vlad-anisov/misha/README.md

# Регулируемая сварная рама домашнего автосимулятора (ревизия 4)

## С чего начать

| Файл | Для кого |
|---|---|
| **[1_Кратко_о_раме.pdf](1_Кратко_о_раме.pdf)** | для всех: что это, как выглядит и регулируется, какие материалы и сколько, какие работы, что осталось решить (10 стр.) |
| **[2_Документация_для_изготовления.pdf](2_Документация_для_изготовления.pdf)** | для мастера, цеха, конструктора: ведомость документов, инструкция по сборке и сварке, допуски, таблицы, ведомость материалов, расчёт, чертежи S01–S12 |
| [docs/06_questions_for_workshop.md](docs/06_questions_for_workshop.md) | короткие вопросы цеху |
| **[docs/07_status_open_items.md](docs/07_status_open_items.md)** | **что осталось решить до заказа резки** |

> ⚠️ **Проект не закончен.** Конструкция проверена по 3D-модели, но до заказа резки нужно решить 4 вопроса:
> сварная рама или с минимумом сварки, ответы цеха, модель рулевой базы, тип сиденья
> (см. [docs/07_status_open_items.md](docs/07_status_open_items.md)).
>
> Комплект для изготовления **одного экземпляра**. Отверстия под конкретные руль, педали и сиденье не
> проектировались (сверлятся по месту). Размеры в мм. **[П]** — предварительные параметры, **[!]** — требуют
> инженерной проверки или уточнения после выбора оборудования.

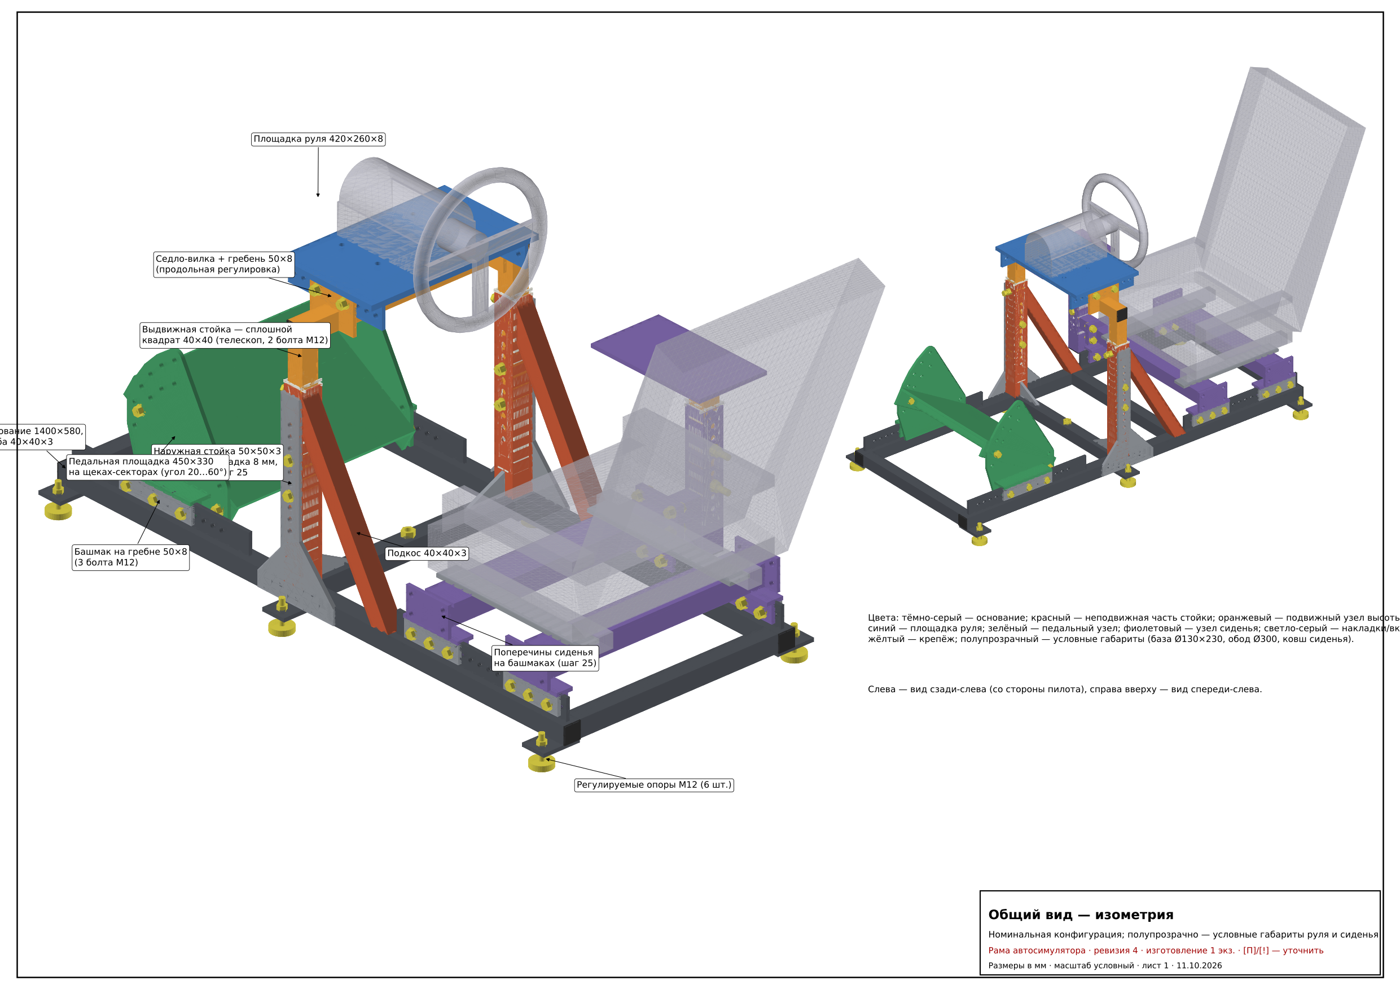
[picture p1: drawings/S01_isometric.png]
Изометрия


## Ключевые параметры [П] (ревизия 4)

| | |
|---|---|
| Основание | **1400 × 580**, труба 40×40×3, 6 регулируемых опор М12 (низ рамы 45 ± 15 от пола; габарит по опорам 686) |
| Металл | Труба 40×40×3, труба 50×50×3, калиброванный квадрат 40×40, лист 8 мм (+ лист 12 мм на площадку руля, 2 мм обычной стали на вкладыши) |
| Рулевые стойки | 50×50×3 на X = 650 (отверстия — труборез), косынки снаружи и изнутри, подкосы 40×40×3 |
| Высота площадки руля | **625…775, шаг 25** (7 положений), номинал 700; телескоп «труба 50×50 + калиброванный квадрат 40×40», 2 болта М12 на стойку, вкладыши по 4 граням + прижим М10; перестановка одним человеком (домкратный винт М16) |
| Руль вперёд-назад | **±75, шаг 25** (7 положений), гребни 50×8 в сёдлах-вилках, 4 болта М12; плавно — салазками сиденья |
| Площадка руля | 420 × 260 × **12**; база снизу или на съёмном фронтальном кронштейне (2 ряда болтов) |
| Педальная площадка | 450 × 330 × 8, угол **20…60°, шаг 10°**; ось X = **260…485, шаг 25**; высота оси **Z 120 / 170** |
| Сиденье | 2 одинаковые поперечины 50×50×3 на X = **1000…1325, шаг 25** (3 болта на конец); адаптеры без отверстий; проставки 8 мм — высота/наклон |
| Шифтер / ручник | Съёмный кронштейн на любой поперечине сиденья, справа или слева, высота **380…480, шаг 25** |
| Масса стали | ≈ 118 кг |
| Крепёж регулировок | М12 8.8 (40 / 45 / 90) в круглых отверстиях, гайки ISO 7042 (замена каждые ~5 перестановок), затяжка 80 Н·м |

## Крайние положения руля (отдельные 3D-изображения)

| Низ + вперёд (H 625, d −75) | Низ + назад (H 625, d +75) |
|---|---|
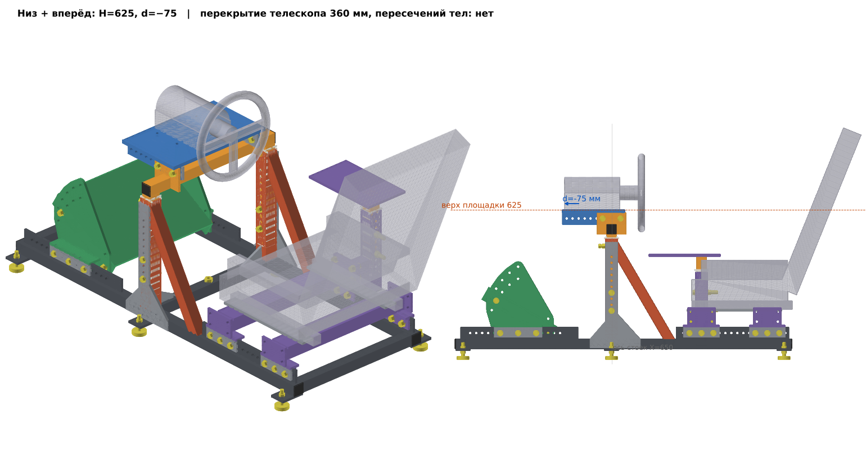
[picture p2: drawings/3d/wheel_low_fwd.png]
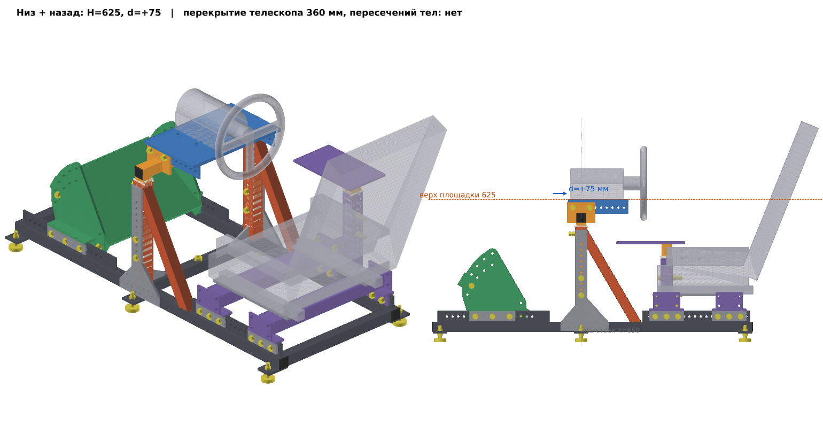
[picture p3: drawings/3d/wheel_low_back.png]
|  |  |
| **Верх + вперёд (H 775, d −75)** | **Верх + назад (H 775, d +75)** |
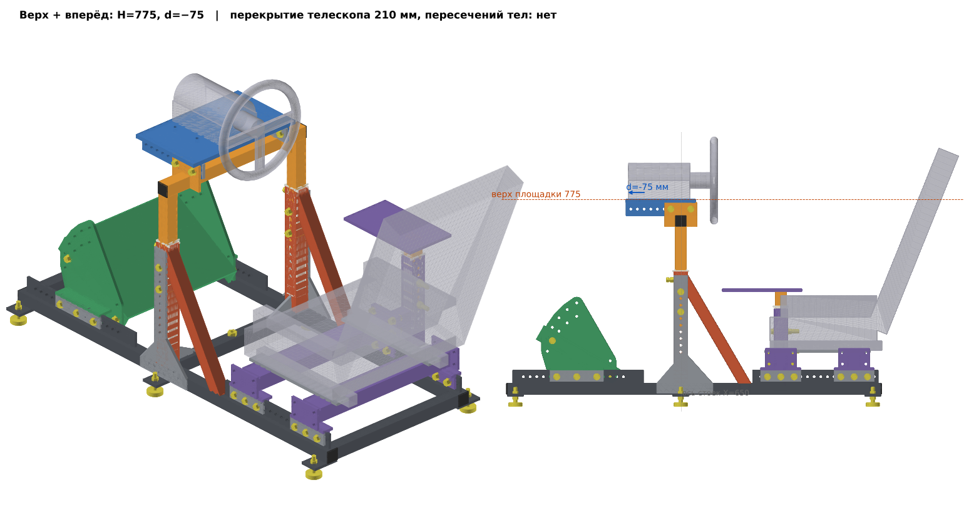
[picture p4: drawings/3d/wheel_high_fwd.png]
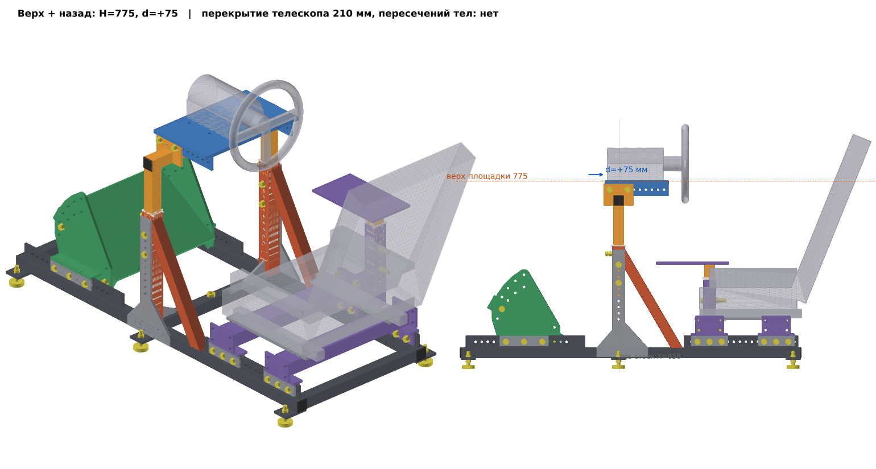
[picture p5: drawings/3d/wheel_high_back.png]
|  |  |

Во всех 16 проверенных конфигурациях (крайние положения руля, педалей, сиденья, кронштейна шифтера, фронтального
крепления) автоматически проверено: пересечений тел нет, каждая гайка сидит на своём болте, **каждый болт можно вынуть
вдоль оси** (`out/interference_report.json`).

## Что где лежит (соответствие пунктам задания)

| № | Требование | Файлы |
|---|---|---|
| 1 | Концепция и обоснование решений | [`docs/01_concept.md`](docs/01_concept.md) |
| 2 | 3D CAD-сборка из отдельных деталей | 188 отдельных тел (200 с фронтальным кронштейном) в группах-подсборках: `out/step/*.step` |
| 3 | STEP AP214 / AP242 + исходник CAD | `out/step/simrig_nominal_AP214.step`, `simrig_nominal_AP242.step`, крайние конфигурации `simrig_<config>_AP214.step`; исходник — параметрическая модель CadQuery `cad/*.py` |
| 4 | STL | `out/stl/simrig_nominal_frame.stl` (каркас), `simrig_nominal_with_refs.stl` (с условными рулём/сиденьем), `simrig_<config>.stl` |
| 5 | Размерные общие виды | `drawings/S01_isometric.png`, `S02_side.png`, `S03_front.png`, `S04_top.png` |
| 6 | Крупные виды механизмов | `drawings/S05_height_mechanism.png`, `S06_foreaft_mechanism.png`; крайние положения — `S07_wheel_extremes.png`, `drawings/3d/` |
| 7 | Схемы регулируемых соединений | `drawings/S09_joint_schemes.png`, `S08_pedal_unit.png`, [`docs/02_adjustable_joints.md`](docs/02_adjustable_joints.md) |
| 8 | Предварительная ведомость материалов и крепежа | [`docs/generated/bom.md`](docs/generated/bom.md) |
| 9 | Параметры к уточнению после выбора оборудования | [`docs/04_open_parameters.md`](docs/04_open_parameters.md) |
| 10 | Почему соединения не смещаются и не расшатываются | [`docs/02_adjustable_joints.md`](docs/02_adjustable_joints.md) §2.1, 2.2, 2.6 |
| — | Нагрузки, допущения, расчёт | [`docs/03_loads_and_checks.md`](docs/03_loads_and_checks.md), [`docs/generated/calc_results.md`](docs/generated/calc_results.md) |
| — | Эргономика P5…P95 | `drawings/S10_ergonomics.png`, `cad/ergonomics.py` |
| — | **Комплект для мастера** | [`docs/05_fabrication_assembly.md`](docs/05_fabrication_assembly.md) (порядок сборки и сварки), `fabrication/dxf/` (лазер, 28 позиций + кондуктор), `fabrication/cut_list.csv` (раскрой и задание на труборез), [`docs/generated/fabrication_tables.md`](docs/generated/fabrication_tables.md), `drawings/S12_laser_parts.png` |
| — | Кронштейн шифтера / ручника | `drawings/S11_shifter_mount.png`, [`docs/02_adjustable_joints.md`](docs/02_adjustable_joints.md) §2.4а |

Все листы одним файлом: `drawings/simrig_concept_drawings.pdf`.

## Как пересобрать

```bash
pip install cadquery matplotlib scipy ezdxf reportlab pypdf
python cad/build.py        # STEP/STL всех конфигураций + проверка столкновений
python calc/frame_fem.py   # стержневая МКЭ-модель, проверки крепежа
python cad/bom.py          # предварительная ведомость
python cad/fabrication.py  # DXF для лазера, раскрой, раскладка деталей
python cad/drawings.py     # листы чертежей и 3D-изображения
python cad/report.py       # 1_Кратко_о_раме.pdf и 2_Документация_для_изготовления.pdf
```

Все размеры — в `cad/params.py`; конфигурации регулировок — `CONFIGS` там же. Система координат:
X от переднего торца к сиденью, Y — поперёк (+ справа от пилота), Z — от пола.

## Ограничения
* Трубы смоделированы без радиусов скругления углов; сварные швы не моделировались.
* Руль, база, сиденье и манекены — условные габариты для проверки компоновки.
* Расчёт — оценочный (идеально жёсткие стыки); реальные перемещения ожидаются в 1.5–3 раза больше.
