vlad-anisov/misha/docs/01_concept.md

# 1. Общая концепция и обоснование решений

> **Статус: комплект для изготовления одного экземпляра (ревизия 4).** Размеры в мм. **[П]** — предварительные
> параметры, **[!]** — требуют инженерной проверки или уточнения после выбора руля, педалей, сиденья.

## 1.1 Состав каркаса

| № | Узел | Решение | Сечения / материал [П] |
|---|---|---|---|
| 1 | Основание | Прямоугольная сварная рама **1400×580**: 2 лонжерона + 4 одинаковые поперечины (X = 20, 650, 890, 1380) | труба 40×40×3 |
| — | «Гребни» | На лонжеронах — гребни 50×8 (лазер, с отверстиями Ø13 шагом 25): педальная зона X 20…510, зона сиденья X 920…1390 | лист 8 мм |
| 2 | Рулевые стойки | Наружные стойки 50×50×3 (отверстия — лазерный труборез) на X = 650, наружная грань заподлицо с лонжероном; косынки снаружи и изнутри | 50×50×3, лист 8 мм |
| 3 | Раскосы | Подкосы назад от стойки (Z≈453) к лонжерону (X=890) + портал «стойки – верхняя поперечина» | 40×40×3 |
| 4 | Высота руля | Телескоп: калиброванный квадрат 40×40 в трубе 50×50×3, вкладыши по 4 граням + прижимной винт М10, 2 болта М12 на стойку; **625…775, шаг 25, номинал 700** | квадрат 40, лист 2 мм нерж. |
| 5 | Руль вперёд-назад | Два гребня 50×8 под площадкой в сёдлах-вилках на верхней поперечине; **±75, шаг 25** | лист 8 мм |
| — | Площадка руля | **420×260×12** (лист 12 — изгиб под базой между гребнями); база снизу или на съёмном **фронтальном кронштейне** (2 ряда болтов) | лист 12 / 8 мм |
| 6 | Педали | Площадка 450×330×8 на оси и одной дуге фиксации; угол **20…60°/10°**, ось **X 260…485/25**, высота оси **Z 120 или 170** | лист 8 мм, рёбра 40×40×3 |
| 7 | Сиденье | 2 **одинаковые** поперечины 50×50×3 на башмаках (3 болта), X **1000…1325/25**; полки 80×8 и адаптерные полосы без отверстий; проставки 8 мм для высоты/наклона | 50×50×3, лист 8 мм |
| 7а | Шифтер / ручник | Съёмный кронштейн на фланце любой поперечины сиденья, справа или слева; телескоп 50/40, высота 380…480/25; платформа 300×170 | 40×40×3, 50×50×3, квадрат 40 |
| 8 | Опоры | 6 точек; пластины выступают наружу (ход шпильки свободен), М12 ×80, ±15 мм; **габарит по опорам 686** | лист 8 мм |
| 9 | Монитор | **Не предусмотрен** (по заданию) | — |

Металл: **труба 40×40×3, труба 50×50×3, калиброванный квадрат 40×40, лист 8 мм** (+ лист 12 мм на площадку руля и
2 мм обычной стали на вкладыши). Масса стали по модели ≈ **118 кг** — рама не ёрзает по полу при торможении с тензодатчиком.

## 1.2 Сквозная идея: одна механика регулировок

Все регулировки — **болты М12 в круглых отверстиях** (положительная фиксация на срез); трение затянутого пакета —
второй уровень. Пазов нет. Для перестановки вдоль рамы везде один узел — **гребень + вилка с прижимной пластиной**:
сплошной гребень 50×8 (нечему сминаться), приварная щека + съёмная прижимная пластина (это одна и та же деталь),
сквозные болты с гайками ISO 7042. Щека стоит с зазором **1 мм** к гребню — допуск на ширину сварной рамы;
зазор выбирает прижимная пластина, поперечины не заклинивает.

## 1.3 Изменения относительно исходных габаритов (с обоснованием)

| Параметр | Исходно | Принято | Почему |
|---|---|---|---|
| Длина основания | ≈1300 | **1400** (+100 спереди) | Проверка P95 (`cad/ergonomics.py`): при 1300 педали упирались в крайнее переднее положение, запаса для высоких не было. +100 спереди дают ход педалей 225 мм |
| Ширина | ≈580 | **580** по лонжеронам; 686 по опорам | Опоры вынесены наружу, чтобы шпилька имела свободный ход вверх |
| Положение стоек | — | X = 650 | Обод на ≈850 — длины рук P5…P95 в норме |
| Высота площадки | ≈625 | **625…775**, шаг 25, номинал 700 | При ободе Ø300 ниже 625 колени P50/P95 касаются обода; 625 — нижнее положение |
| Площадка руля | 420×260 | **420×260×12** | Размер исходный; толщина 12 — база крепится к листу между гребнями (пролёт 360) |
| Педальная площадка | 460×330 | **450×330×8** + рёбра 40×40×3 | −10 мм по ширине — место под гайки оси; прогиб ребра ≈0.09 мм при 1000 Н |
| Стенка труб | 2–3 мм | **3 мм везде** | Одна толщина — мастер не перепутает |
| Наружная стойка | 40×40 | **50×50×3** | Нужна для телескопа с квадратом 40 |

## 1.4 Рулевой узел — как он держит нагрузку

* **Неподвижная часть:** стойки 50×50×3 приварены к лонжеронам и поперечине 40×40×3 под ними, наружная косынка-накладка
  8 мм, внутренняя косынка, подкосы назад — треугольник с каждой стороны. Передний подкос не ставится — он перекрыл бы
  ход педалей.
* **Подвижная часть (П-узел):** два калиброванных квадрата + верхняя поперечина — портал; вкладыши по 4 граням,
  перекрытие в телескопе ≥210 мм.
* **Площадка:** лист 12 мм на двух гребнях (оси через 360 мм) в сёдлах — 2+2 болта.
* Оценка (`calc/frame_fem.py`, база закреплена на листе, стыки идеально жёсткие): центр обода смещается **≈0.9 мм**
  при 1000 Н вниз в худшем положении (H=775, d=+75) и ≈0.55 мм в номинале. **[!]** Реальные значения ожидаются в
  1.5–3 раза больше; подтвердить замером после сборки.

## 1.5 Совместимость с сиденьями

* Поперечины переставляются по гребню (1000…1325, шаг 25), разнос 150…325 мм — под разные салазки и кронштейны.
* Полки 80×8 и адаптерные полосы — **без отверстий**: сверлятся по салазкам/кронштейнам конкретного сиденья.
  Опорная плоскость адаптеров — Z = 211 мм.
* Высота и наклон сиденья: проставки 8 мм (те же полосы, что адаптеры) под обе поперечины (высота) или только
  под заднюю/переднюю (наклон ≈1.5° на проставку).
* Ковш с боковыми кронштейнами: покупные универсальные кронштейны или лазерные Г-образные — после выбора ковша.

## 1.6 История упрощений (ревизии 2–4)

| Было | Стало | Зачем |
|---|---|---|
| Нониус 12.5 мм (4 отв. в седле) | 1 пара отверстий, шаг 25 | Тонкая доводка — салазками сиденья |
| Педали: ось + 2 дуги | Ось + 1 дуга R250 (2 болта на щеку) | Меньше отверстий, нагрузка ≈0.8 кН на болт |
| Трубчатая внутренняя стойка + вварные втулки | **Калиброванный сплошной квадрат 40×40** | Нет втулок, нечему сминаться, жёстче |
| Приварные гайки (48 шт.) | Сквозные болты + ISO 7042 | Нет брызг в резьбе и перекосов гаек |
| Полоса 50×8 / 80×6, лист 6/8, труба 2/3 мм вперемешку | Лазер из листа 8 мм, вся труба 3 мм | Мастер не перепутает |
| Мастер сверлит гребни и стойки | Лазер и труборез, кондуктор Л29 для квадратов | Главный источник брака исключён |
| Щека с зазором 0.2 мм | Зазор 1 мм + прижимная пластина | Сварная рама с обычным допуском не заклинивает поперечины |
| Вкладыши по 2 граням | По 4 граням, комплект 1.5/2.0/2.5 мм, прижимной винт М10 | Нет качки в телескопе |
| Педали с застрявшими болтами (обнаружено проверкой) | Болты вставляются со свободной стороны | Каждый болт вынимается — проверяется автоматически |
| Без шифтера, только нижнее крепление базы | Кронштейн шифтера/ручника; фронтальный кронштейн базы | Функции готовых рам |
| Высота руля 575…725, основание 1300 | 625…775, основание 1400, высота педалей 2 ряда | Эргономика P5…P95 (повторная проверка) |
| Перестановка высоты — вдвоём | Гайка М16 под съёмный домкратный винт | Регулировка одним человеком |

## 1.7 Сравнение с готовыми рамами (~$1000)

| | Наша рама (рев. 4) | Профильные 80×40…160×40 (Sim-Lab GT1 Evo / P1X, Trak Racer TR160) | Playseat Sensation Pro |
|---|---|---|---|
| Жёсткость руля | сварной портал, ≈0.9 мм идеализ. в худшем положении [!] | высокая (профиль, Т-гайки) | ниже, для DD нужен адаптер |
| Фиксация регулировок | болт в круглом отверстии — не проскальзывает | Т-гайки на трении — плавно, но может сползти | фирменные фиксаторы |
| Высота / вылет руля | 625…775 / ±75, шаг 25 | плавно | да |
| Наклон площадки руля | **нет** (вариант — клин/кронштейн после выбора базы) | есть у ряда моделей | да |
| Крепление базы | снизу + фронтальный кронштейн | снизу / спереди / сбоку (опции) | адаптер |
| Педали | угол 20…60°, ход 225, высота 2 ряда | угол, высота, плавно | глубина, высота |
| Сиденье | салазки, проставки (высота/наклон) | слайдер, кронштейны | своё |
| Шифтер / ручник | да, справа/слева | опция | опция |
| Масса | ≈118 кг | 55–65 кг | ≈38 кг |

Вывод: по прочности и надёжности фиксации — не хуже профильных рам; по удобству регулировок — ступенчато и ключом
(против плавных Т-гаек); функционально не хватает только наклона площадки руля (решается после выбора базы).

## 1.8 Что сознательно НЕ спроектировано на этом этапе

* Отверстия под рулевую базу, педали, сиденье, шифтер (оборудование не выбрано).
* Наклон площадки руля — зависит от базы (клин-адаптер или наклонный фронтальный кронштейн).
* Крепление монитора — не предусмотрено по заданию.
* Окончательные моменты затяжки, марки стали, катеты — предварительные (`03_loads_and_checks.md`).
