vlad-anisov/misha/docs/02_adjustable_joints.md

# 2. Регулируемые соединения: схема, принцип фиксации, долговечность

Чертежи: `drawings/S05_height_mechanism.png`, `S06_foreaft_mechanism.png`, `S08_pedal_unit.png`,
`S09_joint_schemes.png`. Крайние положения в 3D: `drawings/3d/*.png`, лист `S07_wheel_extremes.png`.

## 2.1 Высота площадки руля — телескоп с двумя болтами

| | |
|---|---|
| Диапазон / шаг | **625…775 мм** (верх площадки от пола), **шаг 25**, 7 положений, номинал 700 [П] |
| Направляющая | Наружная труба 50×50×3 (неподвижная, шов — на грань X) / **калиброванный сплошной квадрат 40×40** (ГОСТ 8559, h11; оба квадрата связаны верхней поперечиной) |
| Фиксация | **2 болта М12 на стойку**, разнос 75 мм, всего 4; круглые отверстия Ø13 |
| Отверстия | Наружная стойка: ряд 10 отв. шагом 25 (Z = 203…428), режет труборез; в косынке 8 мм — лазер. Квадрат 40×40: 2 отв. на расстоянии 75 — сверлильный станок по лазерному кондуктору Л29 |
| Люфт | **Вкладыши (обычная сталь 2 мм, лазер) по всем 4 граням** — с отверстиями по граням болтов, без отверстий по двум другим; толщина из комплекта 1.5/2.0/2.5 мм (стандартный холоднокатаный лист; остаток зазора ≤0.25 выбирает прижимной винт М10); после подбора приклеиваются к стенке. **Прижимной винт М10** (передняя грань) поджимает вкладыш — выбирает остаточную качку без перетяжки болтов |
| Минимальное перекрытие | 210 мм при H = 775 (≈5 ширин) |
| Доступ | Головки болтов — снаружи каркаса, гайки ISO 7042 — внутри, между стойками (открытый доступ), два ключа 18 мм |

**Почему не смещается и не расшатывается**
1. Вертикальную силу и момент воспринимают два болта в круглых отверстиях на каждой стойке → ни один
   болт не является единственной защитой от поворота; поворот в плане исключён квадратным сечением и
   связью двух стоек поперечиной.
2. Момент от усилия на руле воспринимает телескоп с перекрытием ≥210 мм, а не болты.
3. Пакет под болтом сплошной: косынка 8 + стенка 3 + стальной вкладыш 2 + **сплошной квадрат 40** + вкладыш 2 + стенка 3 →
   ничего не сминается, усилие затяжки не теряется со временем (нет пустот, пластика и краски в пакете).
4. При затяжке 80 Н·м пакет даёт ещё ≈13 кН трения на болт — с большим запасом к рабочим нагрузкам.
5. Люфт убирается подбором вкладыша (один раз при сборке), а не перетяжкой болтов.

**Почему шаг 25 и диапазон 150:** 25 мм — заметно меньше разброса удобной высоты у одного пилота;
тоньше — проставками 5/10 мм под базой. 150 мм перекрывают P5…P95 (лист S10). Верх ограничен
перекрытием телескопа, низ — зазором между верхней поперечиной и головками вкладышей (≈10 мм).

**Перестановка (одним человеком):** вкрутить съёмный домкратный винт М16 в гайку на поперечине основания до упора
в верхнюю поперечину → отпустить прижимы М10 → вынуть 4 болта → винтом поднять/опустить П-узел на нужный шаг →
вставить болты → затянуть крест-накрест → поджать М10 → выкрутить винт. Подвижная масса с базой ≈35–40 кг.

## 2.2 Площадка руля вперёд-назад — гребни в сёдлах-вилках

| | |
|---|---|
| Ход / шаг | **±75 мм**, **шаг 25**, 7 положений [П]; плавная доводка — салазками сиденья |
| Элементы | Под листом 420×260×12 — 2 гребня 50×8 (лазер, 10 отв. Ø13 шагом 25). На верхней поперечине — 2 седла: приварная щека 8 мм + **съёмная прижимная пластина 8 мм**; гребень опирается прямо на поперечину |
| Фиксация | В седле 2 отверстия на расстоянии 75 мм (±37.5 от оси стоек): **2 болта на седло, 4 на площадку**, симметрично слева и справа. Таблица положений — лист S06 |
| Доступ | Головки — изнутри (снизу, между коленями), гайки ISO 7042 — снаружи щёк (зазор до стойки ≈40 мм) |
| Крепление базы | Нижнее — по шаблону базы в листе площадки 12 мм (после выбора базы); **фронтальное** — съёмный кронштейн (плита 300×222×8, основание 170×330, 2 косынки), 4 болта М12 в **2 ряда с разносом 100 мм**; оба варианта проверены в крайних положениях |

**Почему не смещается**
1. Продольная сила передаётся болтами в **совмещённых круглых отверстиях** (срез), а не трением в пазу.
2. Каждый болт стянут в пакет «приварная щека – гребень – прижимная пластина»: две плоскости трения; на срез
   работает плоскость гребень/щека, прижимная пластина поддерживает болт от изгиба.
3. Опрокидывающий момент (до ≈275 Н·м при 1000 Н на ободе в крайнем заднем положении) воспринимается
   парой болтов на плече 75 мм на каждом из двух сёдел: ≈1.8 кН на болт при несущей способности ≈32 кН.
4. Вертикаль вниз передаётся кромкой гребня прямо на верхнюю поперечину — болты не несут вес.
5. Прижимная пластина съёмная, поэтому затяжка не изгибает щёки и не требует «выбирать зазор».

## 2.3 Педальный узел — угол и положение

| | |
|---|---|
| Угол | **20…60° к горизонту, шаг 10°**, 5 положений [П] |
| Положение | ось качания X = **260…485, шаг 25**, 10 положений [П] |
| Высота | ось качания на Z = **120 или 170** (два ряда отверстий в секторе) |
| Фиксация угла | Ось (болт М12) + 1 болт на дуге R250 **на каждой щеке** = 4 болта |
| Фиксация положения | Каретка = башмак на гребне 50×8: 3 сквозных болта М12 на сторону, гайки ISO 7042 |
| Направление наклона | Сиденье справа, педали слева: **верхний край — влево (к переду), нижний край с осью качания — вправо (к сиденью)**; линия площадки идёт сверху-слева вниз-вправо (листы S02, S08) |
| Площадка | Лист 8 мм без отверстий + 2 ребра 40×40×3; поле 450×330 под будущий адаптер педалей |

Момент от тормоза (оценочно 400 Н·м при 2000 Н) воспринимается парой «ось + дуга» на двух щеках,
а не трением одного болта. Болт дуги ≈0.8 кН, оси ≈1.8 кН (несущая способность ≈32 кН).

## 2.4 Поперечины сиденья

Башмаки 150 мм (приварная щека + прижимная пластина, **3 сквозных болта** с гайками ISO 7042 на конец поперечины) на гребне
50×8, шаг 25, X = 1000…1325. Поперечины одинаковые (фланцы на обоих торцах обеих). Поверх — адаптерные полосы и салазки
сиденья (бесступенчатая доводка ≈±100 мм). Высота/наклон — проставки 8 мм под адаптерные полосы.

## 2.4а Кронштейн шифтера / ручника

| | |
|---|---|
| Крепление | 4 болта М12×40 через фланец 116×72×8 к фланцу на торце любой поперечины сиденья (фланцы на обоих торцах обеих поперечин → справа/слева, ближе/дальше) |
| По X | Едет вместе с поперечиной сиденья и салазками — положение относительно пилота сохраняется |
| Высота | 380…480, шаг 25, 5 положений: стакан 50×50×3 (труборез) + калиброванный квадрат 40×40, 2 болта М12×90, вкладыши по 4 граням |
| Платформа | Лист 300×170×8 без отверстий — шифтер и ручник сверлятся по месту |
| Нагрузки (допущение [!]) | Ручник 500 Н, шифтер 200 Н; смещение рукояти ≈1 мм (консервативно) |

## 2.5 Опоры

Пластина 8 мм под лонжероном, выступающая наружу на 50 мм; гайка М12 приварена снизу к выступающей части — шпилька
свободно проходит вверх. Опора М12×80 с контргайкой, ход ±15 мм. 6 опор (X = 20, 650, 1380); габарит по опорам 686.

## 2.6 Общие правила долговечности (п. 10 задания)

* **Положительная фиксация везде:** все регулировочные болты — в круглых отверстиях, на срез.
  Самопроизвольное смещение возможно только после срезания болта (запас по срезу > 15).
* **Стопорение от самоотвинчивания** (вибрация от DD-базы): цельнометаллические самоконтрящиеся гайки ISO 7042
  + плоские шайбы ISO 7089 + правильная затяжка; дополнительно (по желанию) — фиксатор резьбы средней прочности.
  Пружинные шайбы Гровера **не применять**.
* **Ни одна резьба не нарезана в тонкой стенке:** везде сквозные болты с гайками ISO 7042 (приварные гайки — только 6 шт. под опорами).
* **Нет смятия:** под болтами — сплошные гребни, сплошные квадраты 40×40 или пакеты с косынкой и вкладышами.
* **Нет потери затяжки:** не красить толстым слоем контактные поверхности пакетов (маскировать при
  порошковой покраске или ограничиться грунтом ≤ 40 мкм); не класть пластик в пакет под болт.
* **Затяжка** [!]: М12 8.8 + ISO 7042 — **80 Н·м** (≈ 70 % пробной нагрузки). Затягивать динамометрическим ключом,
  повторно проверить после первых 2–5 часов езды.
* **Обслуживание:** визуальный контроль меток на головках («метка краской») раз в месяц; проверка момента
  раз в 3 месяца. **Гайки ISO 7042 в регулировочных узлах менять примерно каждые 5 перестановок** (стопорящий
  эффект цельнометаллической гайки нормируется на ~5 циклов); болты — при следах смятия.
* **Заменяемость:** вкладыши, прижимные пластины, болты, опоры — съёмные; сварные узлы не трогаются.
* **Допуски, без которых регулировки не работают:** расстояние между внутренними гранями гребней 532 −0/+3 мм (щёки
  стоят с зазором 1 мм); одноимённые отверстия левого/правого гребня — по X ±0.5 мм (гребни прихватываются с
  прикрученными поперечинами как кондуктором) — см. `05_fabrication_assembly.md`.

## 2.7 Порядок регулировки посадки

1. Сиденье: поставить поперечины под салазки → сиденье в среднее положение салазок.
2. Педали: угол площадки → положение каретки так, чтобы при полностью нажатом тормозе колено ≈ 120–140°.
3. Руль по высоте: верх обода ниже линии глаз, колени не касаются обода при выжатых педалях.
4. Руль вперёд-назад: запястье ложится на верх обода при спине на спинке.
5. Доводка салазками сиденья; затяжка всех болтов моментом; метки краской.
