vlad-anisov/misha/docs/06_questions_for_workshop.md

# Вопросы цеху / мастеру (коротко)

**Нужно сделать одну раму для автосимулятора. Чертежи есть (DXF и PDF).**

**Материал:**
- лист стали 8 мм (основная часть деталей) и 12 мм (одна деталь 420×260);
- лист стали 2 мм (обрезки, на прокладки-вкладыши);
- труба **квадратная** 40×40, стенка 3 мм, ≈7,5 м;
- труба **квадратная** 50×50, стенка 3 мм, ≈2,5 м;
- брусок (сплошной квадрат) 40×40, ≈1 м.

**Работа:**
1. **Лазер:** вырезать плоские детали по DXF (≈28 позиций, отверстия Ø13).
2. **Трубы:** нарезать в размер по таблице; в трёх трубах 50×50 — ряд отверстий Ø13 (лазерный труборез или сверление).
3. **Сверление:** по 2 отверстия Ø13 в трёх кусках бруска 40×40.
4. **Сварка:** сварить раму по чертежам и инструкции.
5. **Покраска:** после сварки зачистить и покрасить (порошок или грунт + эмаль).

Гибки нет. Болты, гайки, опоры покупаем сами.

**Вопросы:**
1. Что из этого можете сделать вы, что нужно заказывать отдельно?
2. Сколько будет стоить и сколько по времени?
