vlad-anisov/misha/docs/07_status_open_items.md

# 7. Статус проекта: что осталось решить

> **Проект не закончен.** Конструкция рамы готова и проверена по 3D-модели: регулировки работают, детали не
> пересекаются, каждый болт можно вынуть ключом. Но **до заказа резки** нужно закрыть пункты из группы А.
> Пункты Б можно решить позже: эти детали дозаказываются отдельно или сверлятся по месту.
> Пункты В — дополнения, которых нет у этой рамы (у части готовых рам они есть). Пункты Г выполняются после
> изготовления.

## А. Решить до заказа резки (блокирует)

| № | Вопрос | Почему важно | Что меняется | Кто решает |
|---|---|---|---|---|
| А1 | **Сварная рама (как сейчас) или вариант с минимумом сварки** | Влияет на все детали | Сейчас — сварная. Гибрид (сварное только основание) — переделка большинства деталей | владелец |
| А2 | **Ответы цеха** (`06_questions_for_workshop.md`): есть ли лазерный труборез, лист 12 мм, брусок 40×40, точность отверстий Ø13 | От этого зависят DXF и технология | Нет трубореза — добавить шаблоны для сверления труб; нет листа 12 — площадка 8 мм + рёбра; отверстия хуже Ø13 +0,2 — резать Ø12 и развёртывать | цех → конструктор |
| А3 | **Рулевая база: модель, момент, способ крепления** | Расчёт сделан для базы **до 25 Н·м**, массой до 15 кг. Отверстия под базу в площадке 12 мм лучше сразу вырезать лазером — сверлить 12 мм вручную тяжело | Отверстия в Л11 (или во фронтальной плите Л13); при моменте > 25 Н·м — пересчёт, возможно второй подкос | владелец (выбор) → конструктор |
| А4 | **Сиденье: тип** (на салазках / ковш с боковыми кронштейнами) и высота посадки | Рама рассчитана на салазки на двух поперечинах. Для ковша с боковым креплением нужны **боковые кронштейны — не спроектированы**. При очень низкой посадке (формульная) поперечины могут оказаться высоко | Добавить лазерные боковые кронштейны или опустить поперечины | владелец → конструктор |

## Б. Можно решить позже (не мешает резке основной рамы)

| № | Вопрос | Что сделать |
|---|---|---|
| Б1 | Педали: модель и шаблон крепления | Отверстия в педальной площадке Л18 (8 мм) — сверлить по месту или дозаказать лазером адаптер. Проверить усилие тормоза: заложено до 2000 Н |
| Б2 | Шифтер и ручник: модели | Отверстия в платформе Л28 — по месту. Ручник с усилием > 500 Н — усилить платформу |
| Б3 | Наклон площадки руля | Сейчас нет. Клин-адаптер или наклонная фронтальная плита — после выбора базы |
| Б4 | Покраска: баллончики или порошок | Порошок — маскировать зажимаемые поверхности; баллон — грунт тонким слоем |
| Б5 | Калиброванный или обычный брусок 40×40 | Калиброванный лучше; обычный годится, люфт выбирается вкладышами 1,5/2,0/2,5 |

## В. Чего у рамы нет (дополнения; есть у части готовых рам)

| № | Что | Комментарий |
|---|---|---|
| В1 | Крепление монитора | Исключено заданием. Если понадобится — отдельная стойка на полу (не нагружает раму) или кронштейн к передней поперечине (проектировать отдельно) |
| В2 | Кронштейн под блок питания базы, укладка кабелей | Хомуты и небольшая пластина — по месту после выбора базы |
| В3 | Полка под клавиатуру и мышь, кнопочный блок, держатель планшета | Не спроектировано. На торцах поперечин сиденья 4 одинаковых фланца, один занят кронштейном шифтера — на свободные можно ставить второй такой же кронштейн с полкой |
| В4 | Упор для пяток | Не спроектирован; при необходимости — пластина на педальной площадке |
| В5 | Вибромоторы / басшейкеры | Точки крепления не выделены; ставятся на поперечины сиденья или педальную площадку по месту |
| В6 | Перемещение рамы | Масса ≈118 кг, колёс и ручек нет. Переносить вдвоём или по частям (П-узел руля, педали, поперечины сиденья снимаются) |
| В7 | Коврик / защита пола | Покупной коврик под раму |

## Г. После изготовления (проверки и инструмент)

| № | Что | Зачем |
|---|---|---|
| Г1 | **Пробный узел до полного заказа:** одна стойка руля с бруском и вкладышами | Проверить, что телескоп ходит без люфта и отверстия совпадают |
| Г2 | Проверка допусков после сварки: 532 −0/+3 между гребнями, параллельность стоек | Иначе поперечины и педали будут заклинивать |
| Г3 | Замер прогиба руля под нагрузкой | Расчёт идеализирован, реальный прогиб может быть в 1,5–3 раза больше |
| Г4 | Подтяжка всех болтов после 2–5 часов езды, затем раз в 3 месяца | Болты садятся |
| Г5 | Инструмент: динамометрический ключ (80 Н·м), головка и рожковый ключ 18 мм, винт-домкрат М16×700 | Затяжка и перестановка высоты руля одним человеком |

## Что не рассчитано (инженерная проверка [!])

* Сварные швы — катеты назначены по опыту (3–4 мм), отдельно не рассчитаны.
* Расчёт рамы — стержневой, стыки идеально жёсткие.
* Момент затяжки 80 Н·м и трение в пакетах — ориентир; зависят от покрытия.
