vlad-anisov/misha/docs/03_loads_and_checks.md

# 3. Допущения по нагрузкам и результаты проверок

> Каркас **не заявляется** как рассчитанный на любую Direct Drive базу. Ниже — предварительные
> допущения; после выбора оборудования расчёт (`calc/frame_fem.py`, `cad/ergonomics.py`) повторить.

## 3.1 Предварительные допущения [!]

| Параметр | Принято | Пересчитать, если |
|---|---|---|
| Пиковый момент рулевой базы | ≤ 25 Н·м | база мощнее 25 Н·м или есть режимы «удара» |
| Масса базы + руля | ≤ 15 кг | тяжелее |
| Длина базы / положение обода | база ≈230 мм, обод Ø300 на 330 мм от переднего края площадки, ось на 70 мм выше площадки | другая геометрия базы / фронтальное крепление |
| Вертикальная сила на ободе | 1000 Н вниз (опора рукой при посадке), 600 Н вверх | — |
| Продольная сила на ободе | ±500 Н | — |
| Поперечная сила на ободе | 300 Н | — |
| Тормоз (тензодатчик) | 2000 Н по нормали к площадке | датчик > 150 кг |
| Пилот | 120 кг × 1.5 (динамика) | — |
| Материал | S235 (Ст3сп), E = 210 ГПа | другая сталь |
| Крепёж | М12, класс 8.8, гайки ISO 7042 (класс 8) | другой класс крепежа |

## 3.2 Результаты (сводно; полностью — `docs/generated/calc_results.md`)

| Проверка | Результат | Статус |
|---|---|---|
| Перемещение обода, 1000 Н вниз, H=775, d=+75 (худшее) | ≈0.89 мм вдоль / 0.90 мм вниз (идеализ.; база закреплена на листе 12 мм) | [!] подтвердить замером, ожидать ×1.5–3 |
| То же в номинале (H=700, d=0) | ≈0.56 мм вдоль / 0.51 мм вниз | [!] |
| Перемещение обода, 500 Н вдоль, H=775 | ≈0.76 мм | [!] |
| Поперечно 300 Н + 25 Н·м | ≈0.3 мм | [!] |
| Макс. номинальное напряжение в раме | ≈28 МПа (S235: 235) | ок для концепции; сварные швы — проверить |
| Болт седла в худшем случае | ≈1.8 кН при Fv,Rd ≈ 32 кН | запас >15 |
| Трение пакета М12 при 80 Н·м | ≈13 кН на болт | [!] μ зависит от покрытия (не красить зажимаемые поверхности) |
| Собираемость / обслуживание | Каждый болт вынимается вдоль оси (проверено по модели во всех 16 конфигурациях); торцевая головка 18 мм проходит везде, кроме гаек педального узла и фланца кронштейна — там рожковый ключ | `out/interference_report.json` |
| Реакция направляющих телескопа | ≈0.65 кН на стойку при перекрытии 210 мм (худший из LC1 и продольной силы) | ок |
| Фронтальный кронштейн: 1000 Н на ободе | 285 Н·м на 2 ряда болтов (разнос 100) → ≈1.4 кН отрыва на болт | [!] прогиб листа у болтов — замер |
| Кронштейн шифтера: ручник 500 Н | смещение рукояти ≈1.1 мм (кручение поперечины 50×50×3, консервативно); болты фланца ≈2.8 кН на растяжение | [!] замер после сборки |
| Педали: болт дуги / оси | 0.8 / 1.8 кН | запас >15 |
| Ребро педальной площадки 40×40×3 | σ ≈ 22 МПа, прогиб ≈ 0.09 мм | ок; лист 8 мм — проверить с адаптером педалей |
| Масса стали | ≈118 кг с кронштейном и фронтальным креплением (см. ведомость) | — |
| Опрокидывание пустой рамы вбок силой на ободе | ≈370 Н; с пилотом 80 кг — ≈620 Н (консервативно, плечо по лонжерону; по опорам больше) | пустую раму не тянуть за руль |
| Столкновения деталей | 16 конфигураций (крайние H, d, педали, сиденье, кронштейн шифтера низ/верх/слева, фронтальный кронштейн в крайних положениях) — пересечений нет | `out/interference_report.json` |
| Собираемость крепежа | В каждой конфигурации проверено: каждая гайка целиком сидит на стержне своего болта (длины М12×40/×45/×90 достаточны) | `out/interference_report.json` |
| Эргономика | Подходящих комбинаций регулировок: P5 — 4682, P50 — 4452, P95 — 3534; номинал (H=700, d=0, педали 385/30°) для P50: зазор ног до обода ≈98 мм | лист S10; [!] повторить с реальным сиденьем и рулём |

## 3.3 Ограничения модели

* Стыки — абсолютно жёсткие; податливость сварных узлов, зазоры в отверстиях (Ø13 под М12) и местные деформации
  стенок не учтены. База руля закреплена на листе площадки в точках Y=±40 (условный шаблон).
* Пол и опоры — жёсткие.
* Динамика (резонанс рамы под вибрацией базы) не считалась. **[!]** После изготовления — простой замер:
  индикатор часового типа на ободе при нагрузке 500 Н; при «гудении» — добавить диагональ в основание
  или увеличить стенку стоек.
* Сварные швы не рассчитывались: принимать катет ≥ 3 мм по всему контуру, стойки и косынки — сплошной шов.
