vlad-anisov/misha/docs/04_open_parameters.md

# 4. Параметры, которые нужно уточнить после выбора оборудования

## 4.1 После выбора рулевой базы и руля
1. Пиковый и длительный момент, масса, тип крепления (снизу / спереди / боковые кронштейны).
2. Шаблон отверстий базы → разметка и сверловка площадки (или промежуточная адаптерная пластина).
3. Длина базы и вылет обода → положение обода; повторить `cad/ergonomics.py` и `calc/frame_fem.py`.
4. Диаметр и форма обода (плоский низ, формульный руль) → зазор до коленей, нужный диапазон высоты.
5. Если момент > 25 Н·м: рассмотреть второй подкос, косынки у верхней поперечины.
6. Кабели и блок питания — места крепления (не силовые, на хомутах).

## 4.2 После выбора педалей
1. Шаблон отверстий и габарит основания педалей → адаптерная пластина/рейки на листе 450×330.
2. Максимальная сила тормоза (тензодатчик) → проверка листа, рёбер и болтов оси.
3. Нужный угол площадки (у некоторых педалей свой регулируемый угол) — возможно, достаточно 3 положений.
4. Высота педалей над листом → положение пятки, повторная проверка эргономики.
5. Нужен ли упор для пятки / подножка.

## 4.3 После выбора сиденья
1. Тип: ковш с боковыми кронштейнами / автомобильное с салазками / ковш на салазках.
2. Шаблон отверстий салазок или кронштейнов → сверловка полок поперечин и адаптерных полос.
3. Ширина сиденья (бокс 510 мм в модели) и наклон спинки → проход у стоек и подкосов.
4. Длина салазок и их ход → выбор шага поперечин.
5. Высота точки H → повторная проверка коленей и обода; при низкой точке H может понадобиться
   опустить поперечины (вариант — поперечины между лонжеронами).
6. Вылет спинки за основание (сейчас ≈150–250 мм) и положение поперечин сиденья (1000…1325).

## 4.3а После выбора шифтера и ручника
1. Шаблон крепления устройств → сверловка платформы 300×170 (или адаптер).
2. Усилие ручника (гидравлический/тензо — до 500–800 Н) → проверка кронштейна; при > 500 Н — косынка под платформой
   или платформа 10 мм.
3. Сторона установки (справа/слева) и нужная высота рукояти → выбор положения 380…480.

## 4.3б Наклон площадки руля
Не спроектирован, т.к. зависит от базы: после выбора базы — клиновой адаптер (лазерные щёки + плита) под нижнее
крепление или фронтальный кронштейн с наклонной плитой (5°/10°).

## 4.4 Требует инженерной проверки независимо от оборудования [!]
* Итоговый момент затяжки М12 8.8 с гайками ISO 7042 (ориентир 80 Н·м) — по паспорту крепежа и покрытию.
* Коэффициент трения в пакетах с выбранным покрытием (порошок/цинк/грунт).
* Сварка: катеты, порядок, деформации гребней (длинные полосы — прихватки с шагом и сварка вразбежку).
* Фактическая жёсткость рулевого узла — замер после изготовления.
* Подбор толщины стальных вкладышей телескопа по фактическим размерам труб (допуски ±0.5 мм по наружному размеру,
  внутренний шов наружной трубы — зачистить или ориентировать на грань X).
