vlad-anisov/misha/drawings/S02_side.png

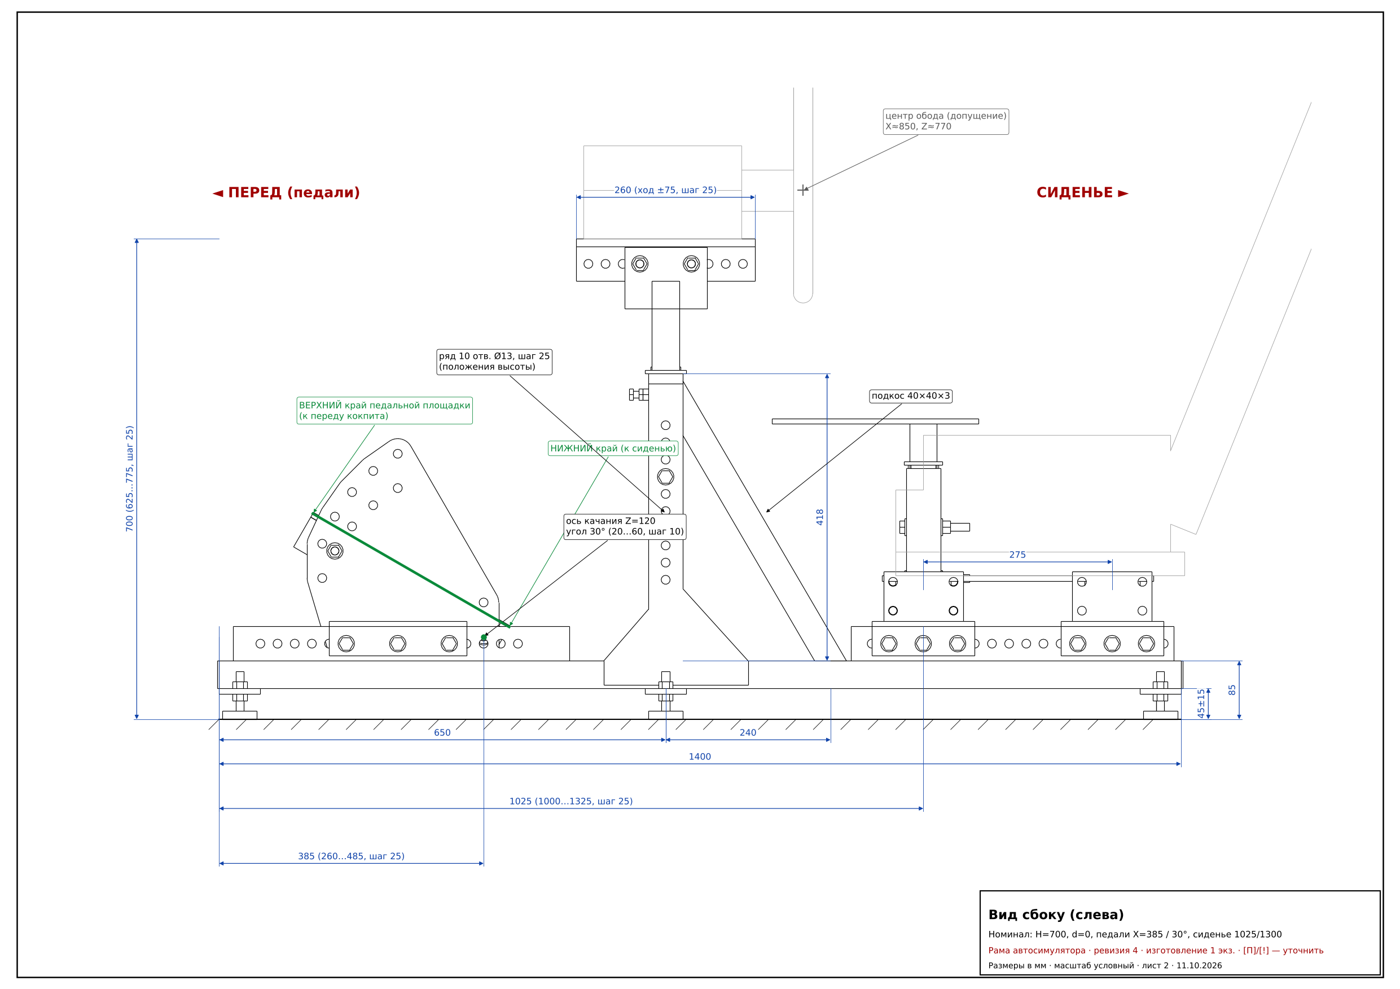
drawings/S02_side.png
