vlad-anisov/misha/drawings/S03_front.png

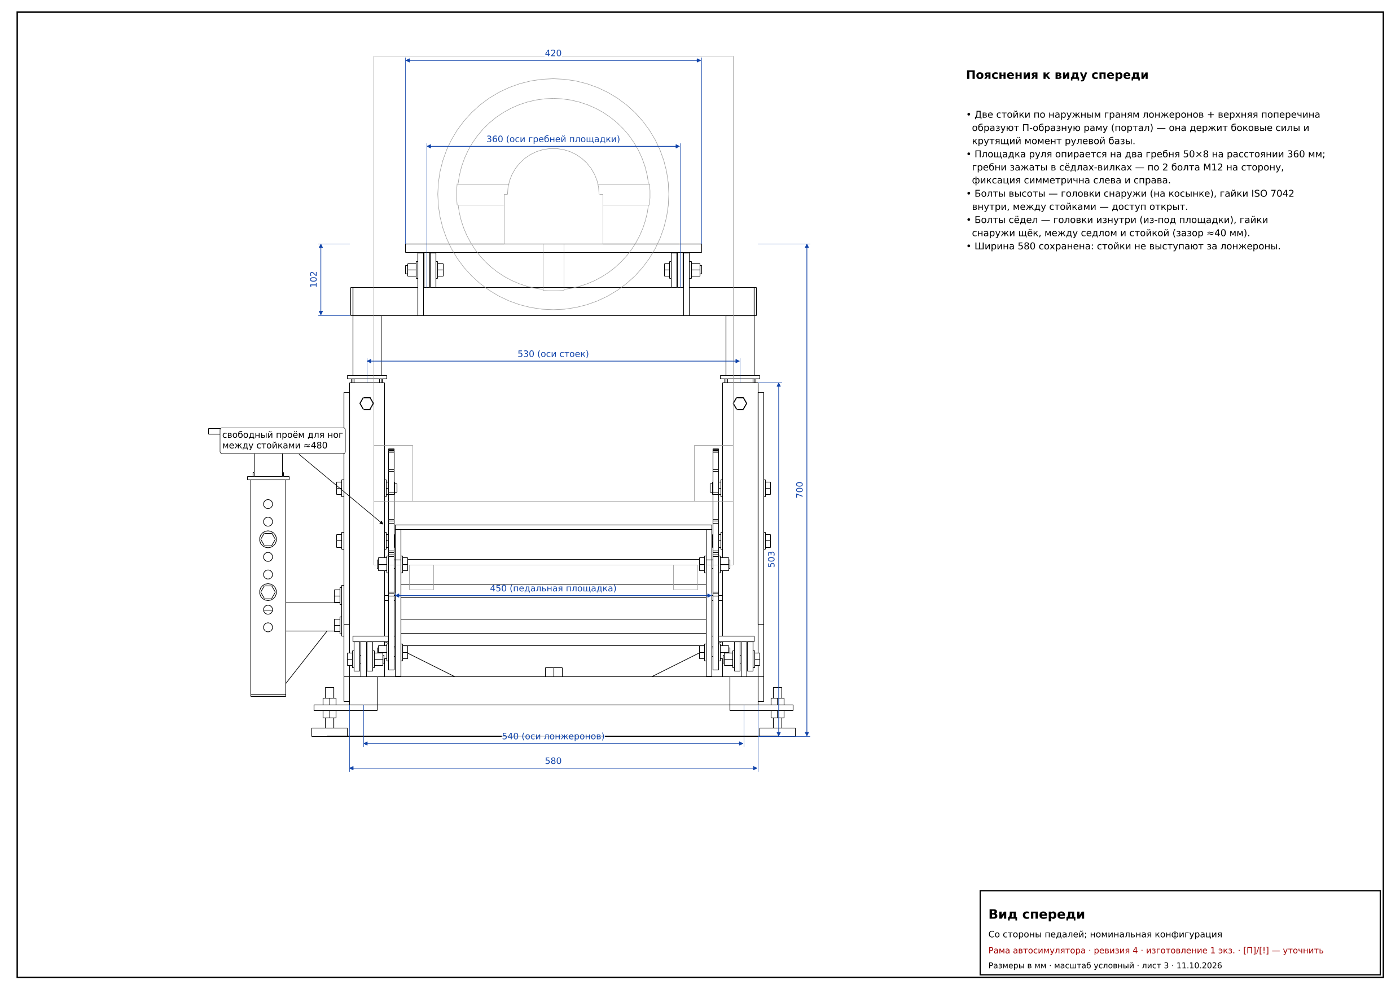
drawings/S03_front.png
