vlad-anisov/misha/drawings/S04_top.png

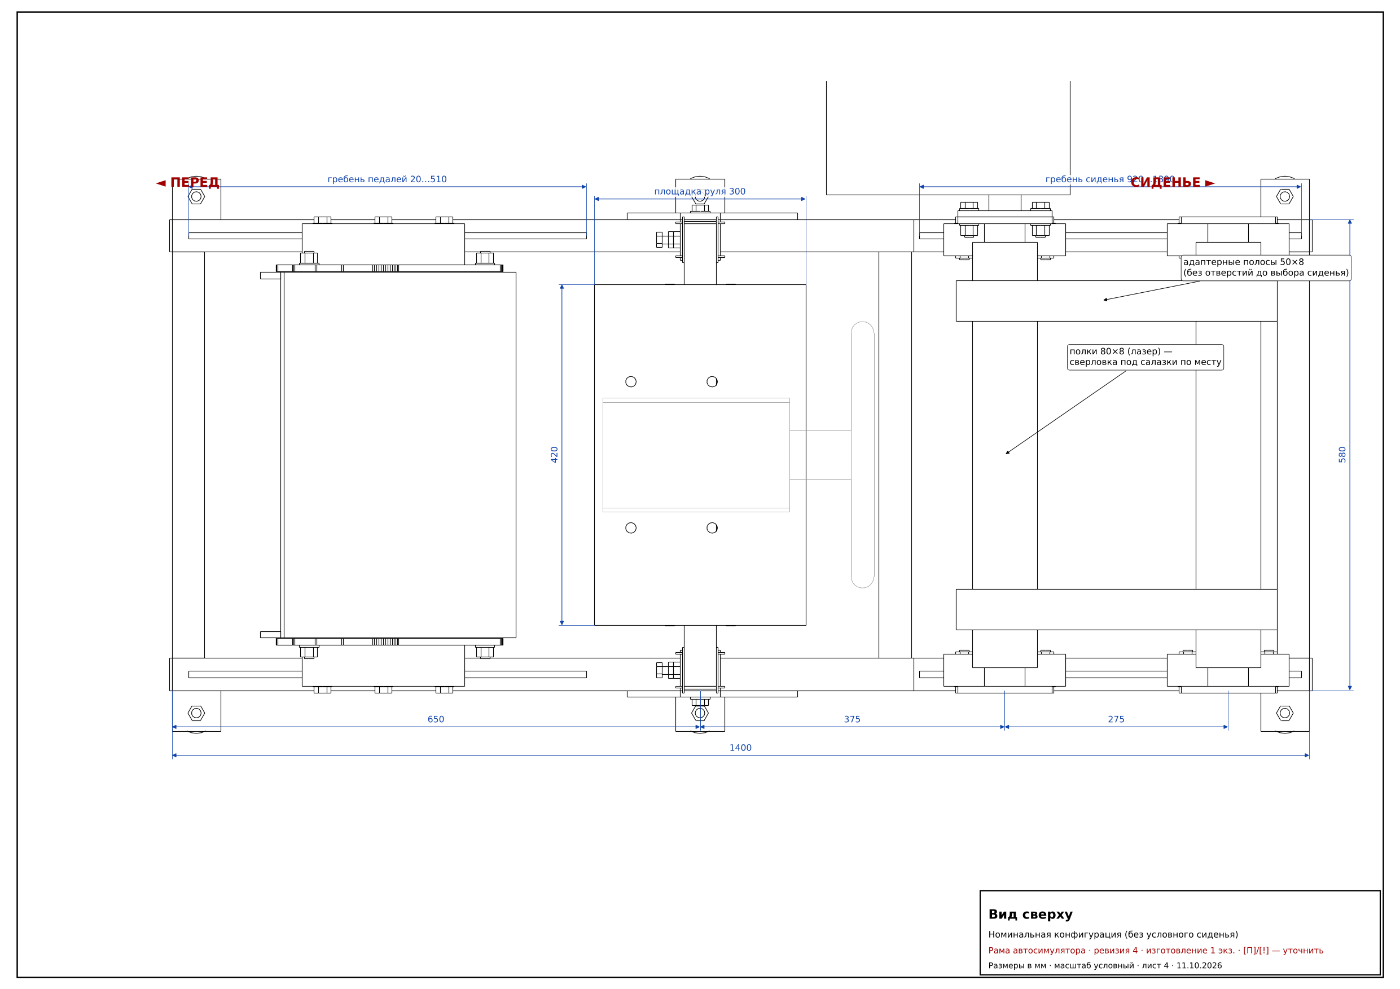
drawings/S04_top.png
