vlad-anisov/misha/drawings/S06_foreaft_mechanism.png

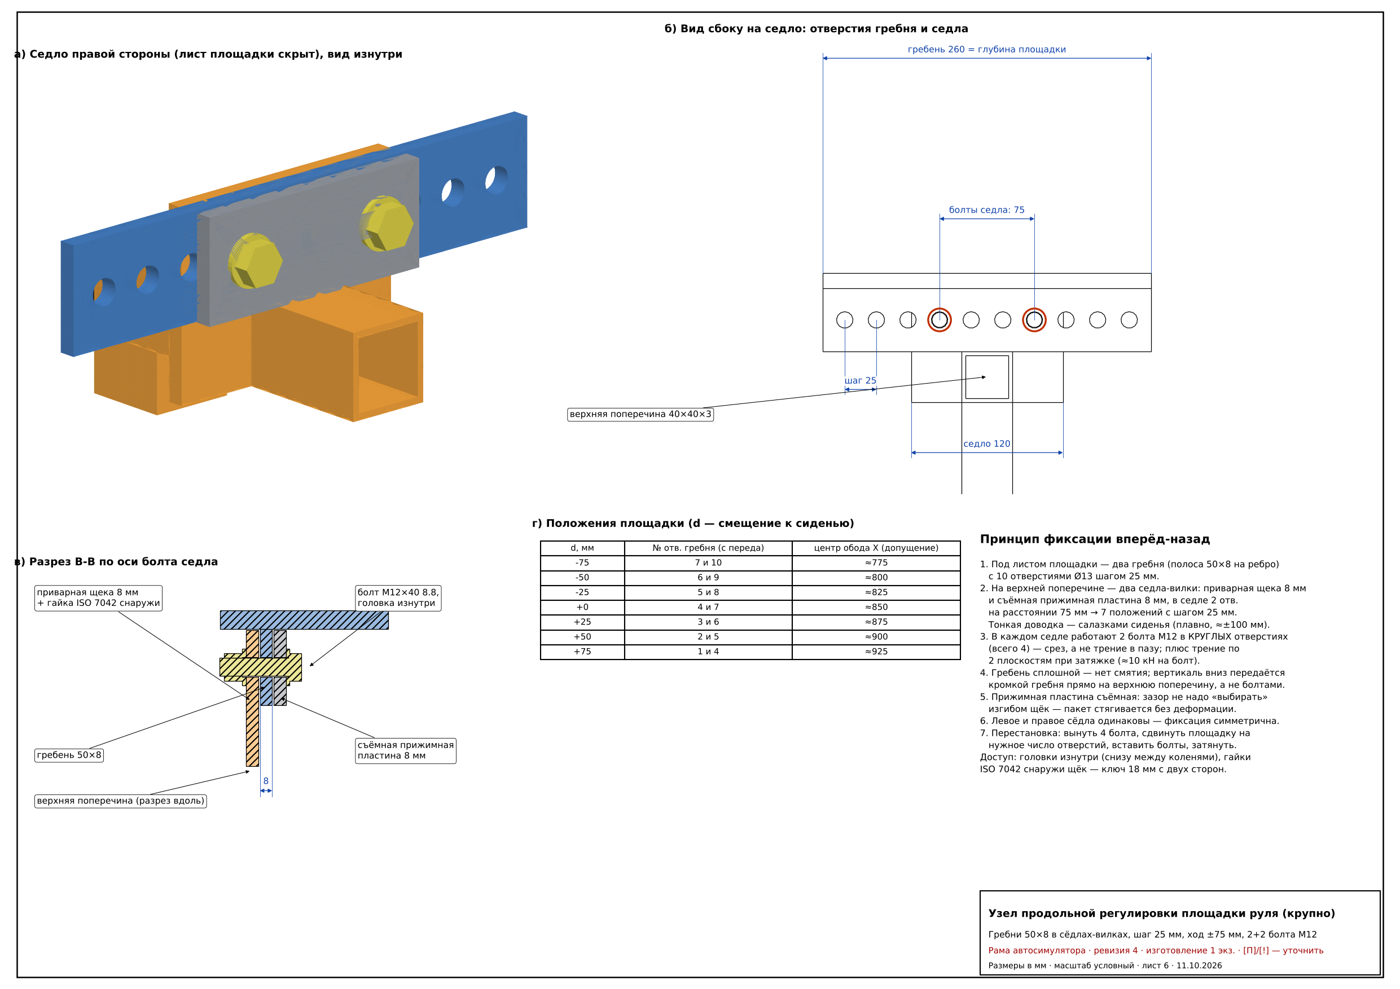
drawings/S06_foreaft_mechanism.png
