vlad-anisov/misha/drawings/S07_wheel_extremes.png

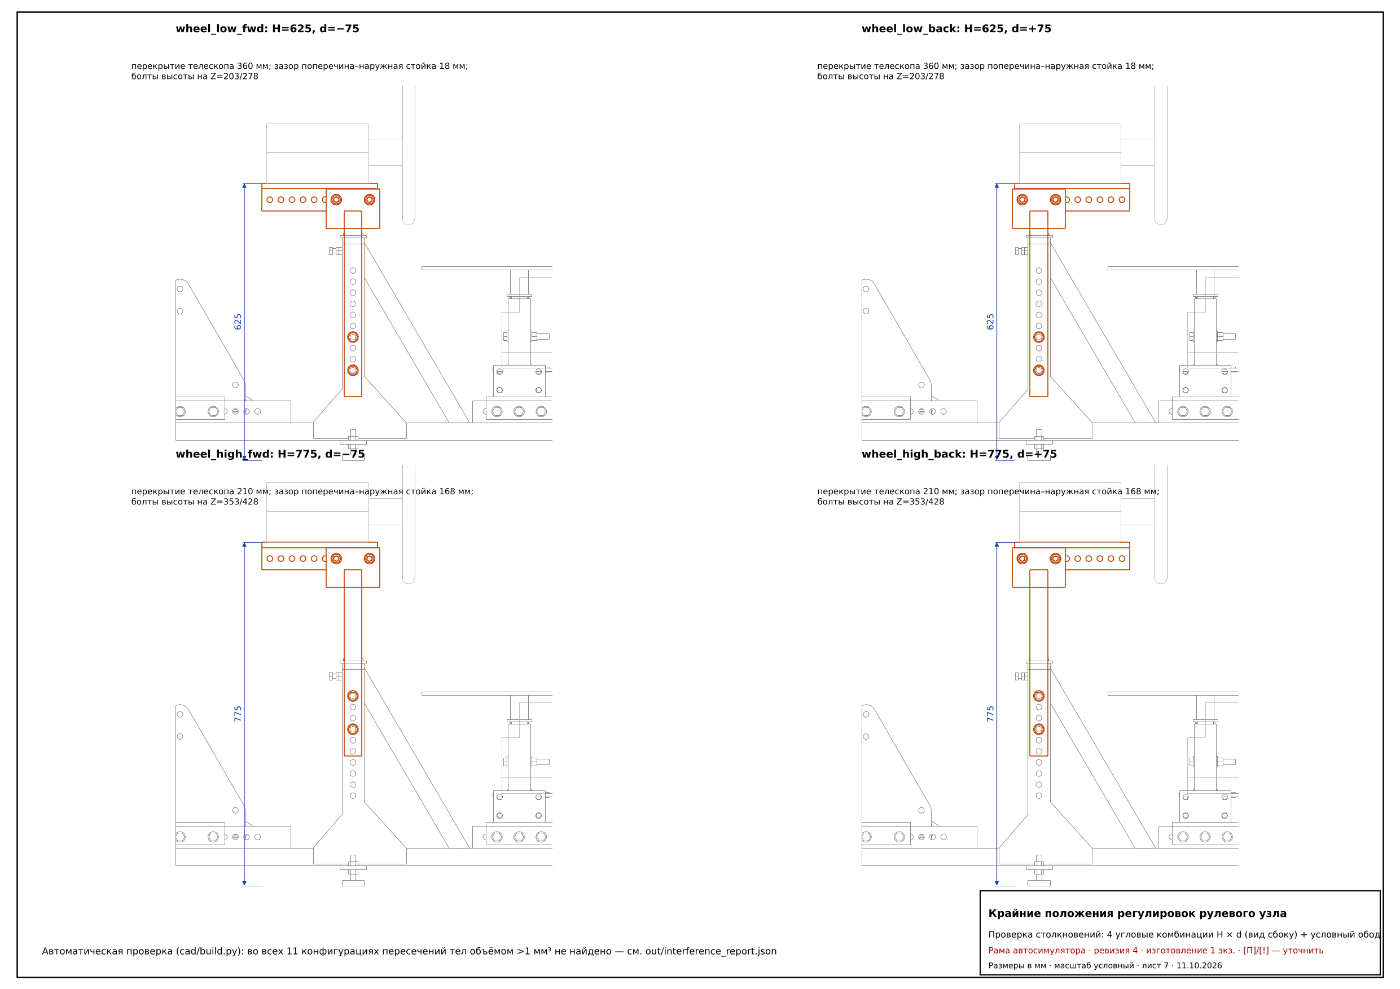
drawings/S07_wheel_extremes.png
