vlad-anisov/misha/drawings/S08_pedal_unit.png

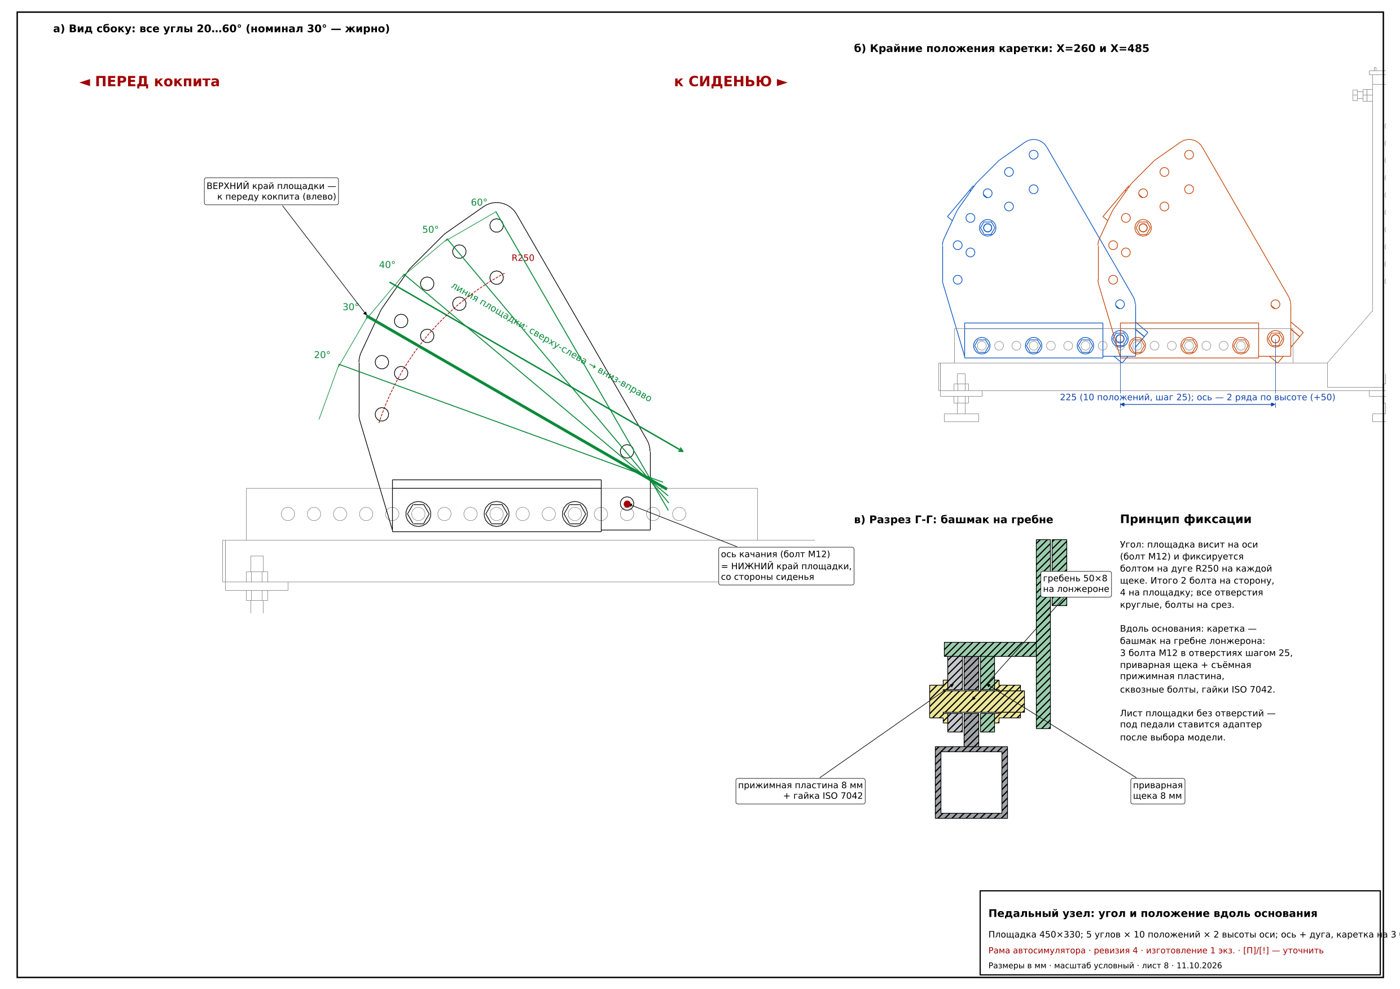
drawings/S08_pedal_unit.png
