vlad-anisov/misha/drawings/S09_joint_schemes.png

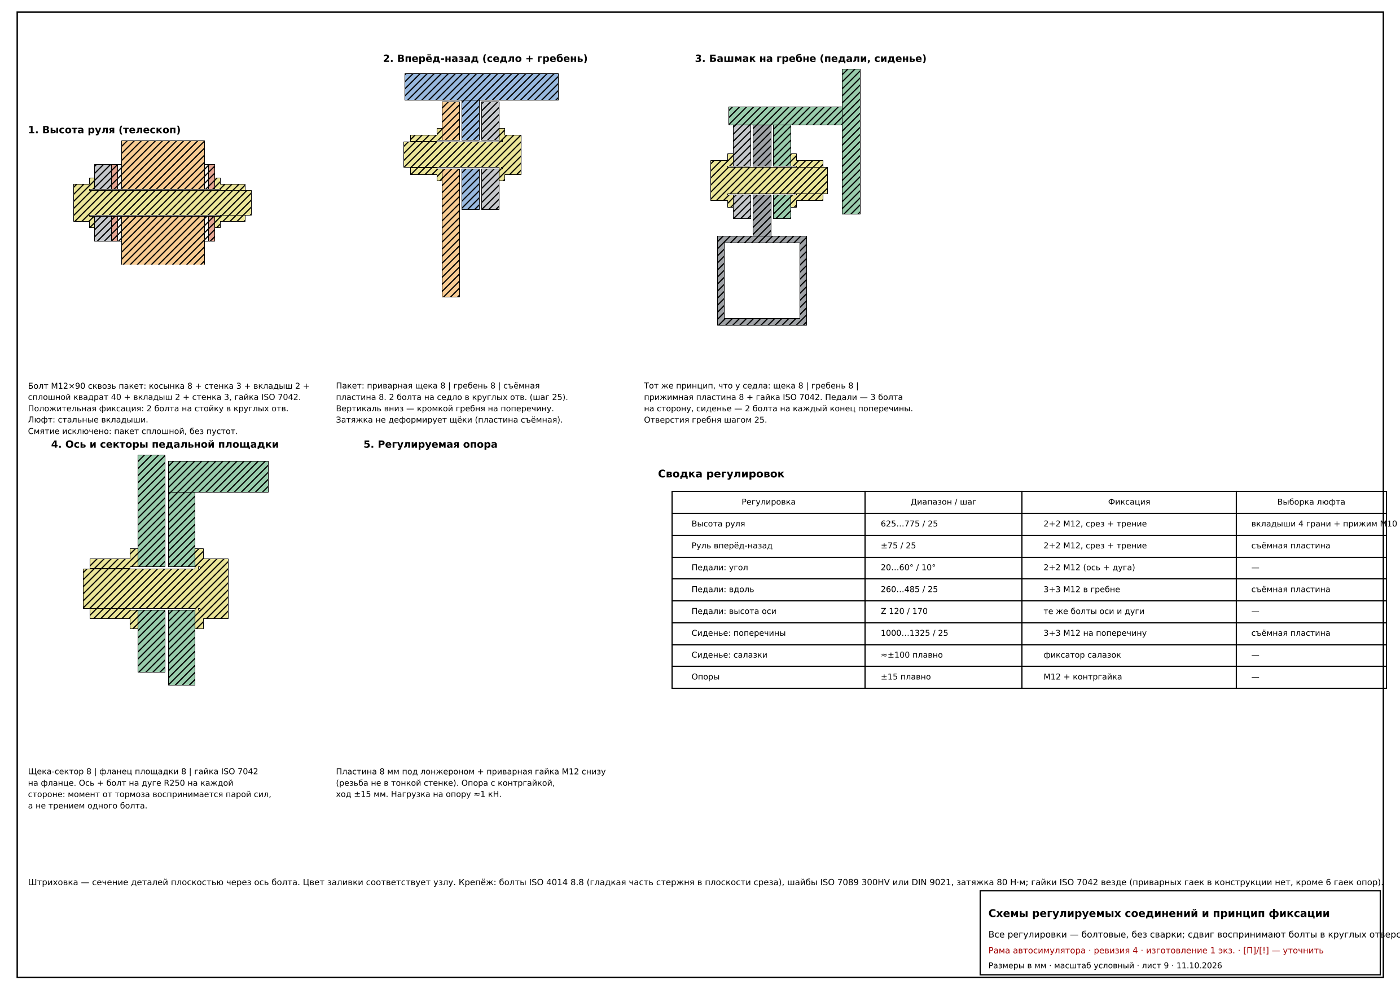
drawings/S09_joint_schemes.png
