vlad-anisov/misha/drawings/S10_ergonomics.png

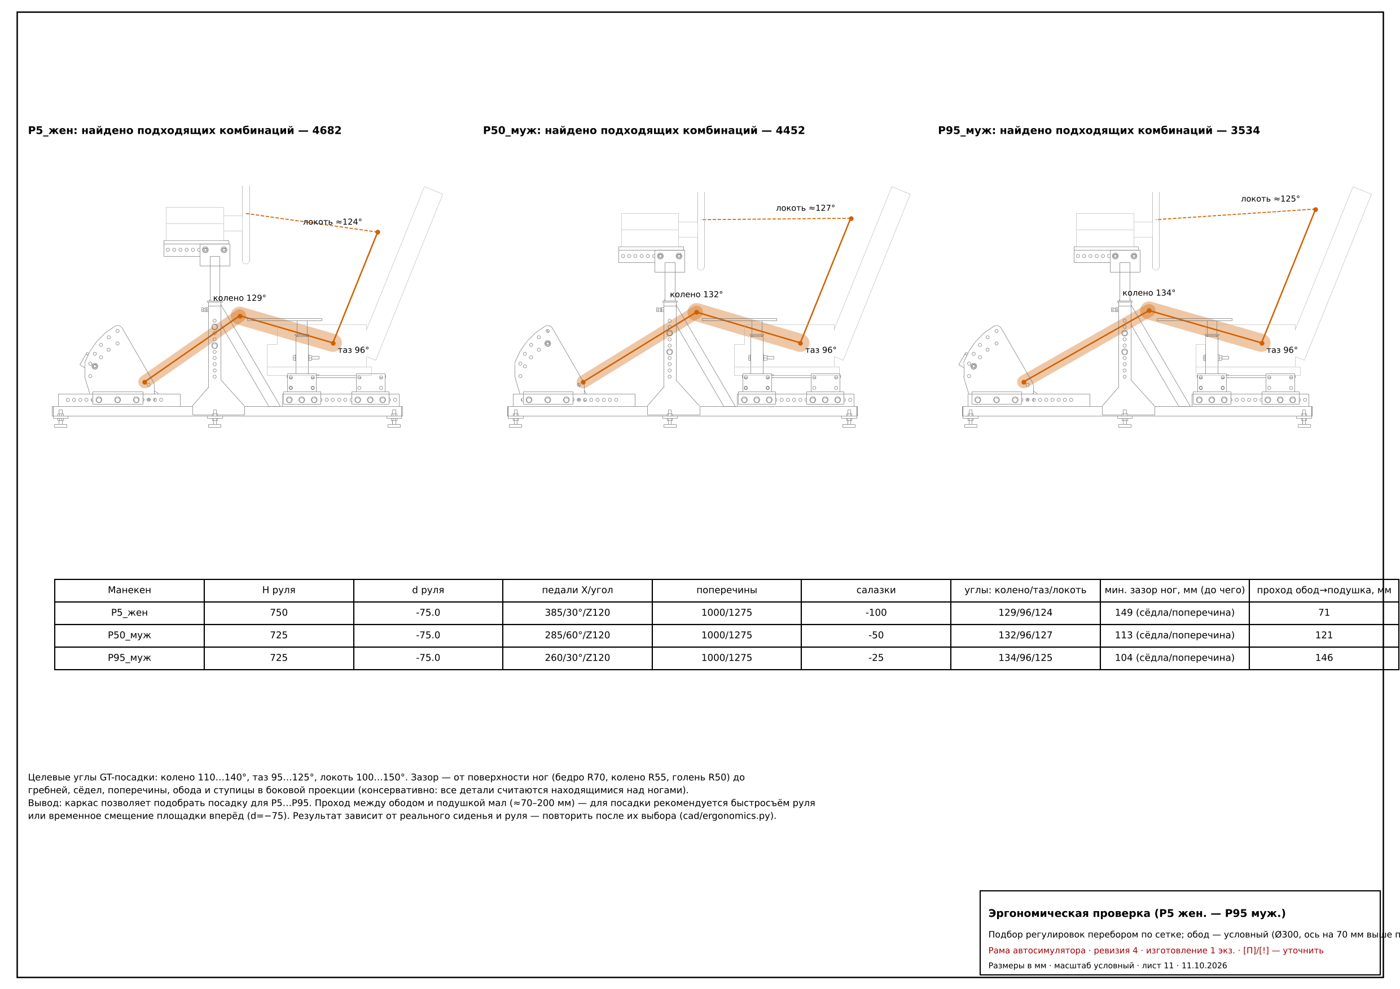
drawings/S10_ergonomics.png
