vlad-anisov/misha/drawings/S11_shifter_mount.png

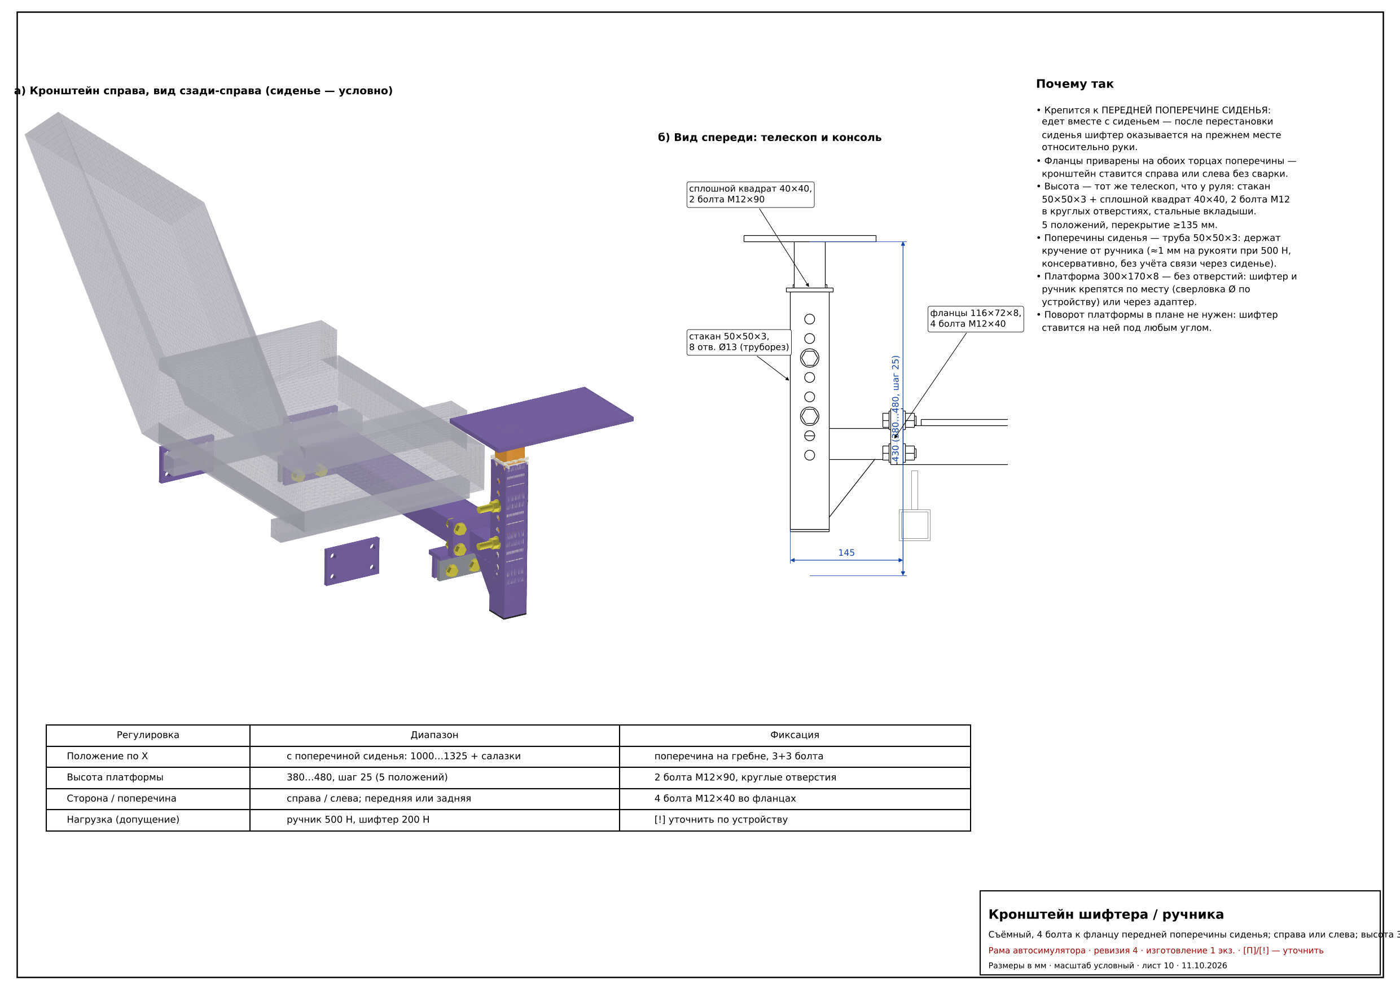
drawings/S11_shifter_mount.png
