vlad-anisov/misha/docs/generated/bom.md

# Предварительная ведомость материалов и крепежа (генерируется cad/bom.py)

> **Не производственная спецификация.** Количества и сечения сняты с концептуальной модели (номинальная конфигурация). Длины — по модели без припусков на рез; трубы показаны без радиусов скругления углов. Перед заказом: проверить сортамент поставщика, добавить 10–15 % на рез и брак, уточнить крепёж после выбора руля, педалей и сиденья (их крепёж здесь НЕ учтён).

## Основание

| Позиция (по модели) | Материал / изделие | Кол-во | Масса, кг (≈) |
|---|---|---|---|
| base_rail | Труба 40x40x3, L=1400 | 2 | 9.76 |
| base_cross | Труба 40x40x3, L=500 | 4 | 6.97 |
| fin_pedal | Лист 8 мм (лазер), гребень 50x490, 16 отв. Ø13 шаг 25 | 2 | 2.81 |
| fin_seat | Лист 8 мм (лазер), гребень 50x470, 18 отв. Ø13 шаг 25 | 2 | 2.65 |
| foot_plate | Лист 8 мм 60x90, отв. Ø13 (выступает наружу) | 6 | 1.98 |

## Рулевые стойки (неподвижная часть)

| Позиция (по модели) | Материал / изделие | Кол-во | Масса, кг (≈) |
|---|---|---|---|
| tower_outer_post | Труба 50x50x3, L=418, 10 отв. Ø13 шаг 25, отв. Ø10.5 под прижим | 2 | 3.57 |
| tower_gusset_outer | Лист 8 мм, косынка-накладка, 10 отв. Ø13 | 2 | 4.23 |
| tower_liner_steel_in, tower_liner_steel_out | Лист 2 мм ст. (холоднокат., лазер), вкладыш Т-образный 36/60x373, 10 отв. Ø13; подбор 1.5/2.0/2.5 | 4 | 0.10 |
| tower_liner_x_front, tower_liner_x_rear | Лист 2 мм ст. (холоднокат., лазер), вкладыш Т-образный 36/56x378, без отв.; подбор 1.5/2.0/2.5 | 4 | 0.11 |
| tower_brace | Труба 40x40x3, подкос, L≈426 по оси | 2 | 2.97 |
| tower_gusset_inner | Лист 8 мм (лазер), косынка 100x50 (ниже гаек нижнего положения) | 2 | 0.31 |

## Узел высоты (подвижный П-узел) и сёдла

| Позиция (по модели) | Материал / изделие | Кол-во | Масса, кг (≈) |
|---|---|---|---|
| height_inner_post | Квадрат сплошной 40x40 (калиброванный), L=380, 2 отв. Ø13 (разнос 75) — станок + кондуктор | 2 | 9.38 |
| height_head_cross | Труба 40x40x3, L=570 | 1 | 1.99 |
| saddle_cheek_welded | Лист 8 мм 120x89, вырез под поперечину, 2 отв. Ø13 | 2 | 1.11 |
| saddle_clamp_plate | Лист 8 мм 120x49, 2 отв. Ø13, съёмная прижимная | 2 | 0.71 |

## Площадка руля

| Позиция (по модели) | Материал / изделие | Кол-во | Масса, кг (≈) |
|---|---|---|---|
| deck_fin | Лист 8 мм (лазер), гребень 50x260, 10 отв. Ø13 шаг 25 | 2 | 1.47 |
| deck_plate | Лист 12 мм 420x260, 4 отв. Ø13 под фронтальный кронштейн (отверстия под базу — после выбора базы) | 1 | 10.24 |

## Педальный узел

| Позиция (по модели) | Материал / изделие | Кол-во | Масса, кг (≈) |
|---|---|---|---|
| pedal_shoe_top | Лист 8 мм 200x51 | 2 | 1.28 |
| pedal_shoe_cheek | Лист 8 мм 200x42, 3 отв. Ø13 (приварная щека = та же деталь, что прижимная) | 2 | 1.01 |
| pedal_shoe_clamp | Лист 8 мм 200x42, 3 отв. Ø13 (съёмная прижимная = та же деталь, что щека) | 2 | 1.01 |
| pedal_sector_plate | Лист 8 мм, щека-сектор, 12 отв. Ø13 | 2 | 7.70 |
| pedal_tray_plate | Лист 8 мм 450x330 (отв. под педали — по месту) | 1 | 9.33 |
| pedal_tray_flange | Лист 8 мм (лазер), фланец 50x330, 2 отв. Ø13 | 2 | 2.04 |
| pedal_tray_stiffener | Труба 40x40x3, L=434 | 2 | 3.03 |

## Узел сиденья

| Позиция (по модели) | Материал / изделие | Кол-во | Масса, кг (≈) |
|---|---|---|---|
| seat_shoe1_top, seat_shoe2_top | Лист 8 мм 150x40 | 4 | 1.51 |
| seat_shoe1_cheek, seat_shoe2_cheek | Лист 8 мм 150x42, 3 отв. Ø13 (приварная щека = та же деталь, что прижимная) | 4 | 1.48 |
| seat_shoe1_clamp, seat_shoe2_clamp | Лист 8 мм 150x42, 3 отв. Ø13 (съёмная прижимная = та же деталь, что щека) | 4 | 1.48 |
| seat_crossbar | Труба 50x50x3, L=570 (жёсткая на кручение — держит кронштейн ручника) | 2 | 5.05 |
| seat_crossbar_flange | Лист 8 мм (лазер) 80x524 — полка поперечины (сверловка под салазки по месту) | 2 | 5.27 |
| seat_adapter_bar | Лист 8 мм (лазер) 50x395 — адаптер под салазки (отверстия по месту) | 2 | 2.48 |
| seat_end_flange_L, seat_end_flange_R | Лист 8 мм (лазер) 116x72, 4 отв. Ø13 — фланец под боковой кронштейн | 4 | 1.96 |

## Кронштейн шифтера / ручника

| Позиция (по модели) | Материал / изделие | Кол-во | Масса, кг (≈) |
|---|---|---|---|
| side_flange | Лист 8 мм (лазер) 116x72, 4 отв. Ø13 | 1 | 0.49 |
| side_arm | Труба 40x40x3, L=79 | 1 | 0.28 |
| side_cup | Труба 50x50x3, L=305, 8 отв. Ø13 шаг 25 (труборез) | 1 | 1.30 |
| side_gusset | Лист 8 мм (лазер), косынка | 1 | 0.14 |
| side_liner_front, side_liner_rear | Лист 2 мм ст. (холоднокат., лазер), вкладыш Т-образный, 8 отв. Ø13 | 2 | 0.03 |
| side_liner_y_in, side_liner_y_out | Лист 2 мм ст. (холоднокат., лазер), вкладыш Т-образный, без отв. | 2 | 0.04 |
| side_bar | Квадрат сплошной 40x40 (калиброванный), L=250, 2 отв. Ø13 (разнос 75) — станок + кондуктор | 1 | 3.06 |
| side_platform | Лист 8 мм 300x170 — платформа шифтера/ручника (отверстия под устройства — по месту) | 1 | 3.20 |

## Крепёж и покупные изделия

| Изделие | Кол-во в модели | Где |
|---|---|---|
| Заглушка пластиковая 40x40 (вставная) | 4 | Основание |
| Гайка М12 (приварная, под пластиной) | 6 | Основание |
| Опора регулируемая М12x80, шарнирная, Ø50 + контргайка сверху | 6 | Основание |
| Гайка приварная М10 (прижим) | 2 | Рулевые стойки (неподвижная часть) |
| Винт М10x30 + контргайка (прижим вкладыша) | 2 | Рулевые стойки (неподвижная часть) |
| Гайка М16 приварная (под съёмный домкратный винт М16) | 1 | Рулевые стойки (неподвижная часть) |
| Болт М12x90 8.8 + шайба | 6 | Кронштейн шифтера / ручника; Узел высоты (подвижный П-узел) и сёдла |
| Гайка ISO 7042 М12 + шайба DIN 9021 | 6 | Кронштейн шифтера / ручника; Узел высоты (подвижный П-узел) и сёдла |
| Заглушка пластиковая 40x40 | 2 | Узел высоты (подвижный П-узел) и сёдла |
| Болт М12x45 8.8 + шайба | 22 | Педальный узел; Площадка руля; Узел сиденья |
| Гайка ISO 7042 М12 + шайба | 30 | Кронштейн шифтера / ручника; Педальный узел; Площадка руля; Узел сиденья |
| Болт М12x40 8.8 + шайба | 8 | Кронштейн шифтера / ручника; Педальный узел |
| Заглушка пластиковая 50x50 | 1 | Кронштейн шифтера / ручника |

**Итого сталь по модели ≈ 113 кг** (без крепежа).

### Рекомендуемый запас и уточнения по крепежу
* Болты регулировок: ISO 4014 (с гладкой частью стержня в плоскости среза), класс 8.8, оцинк., М12×40, М12×45 и М12×90. Запас +20 %.
* Гайки — ISO 7042 (цельнометаллические самоконтрящиеся) + шайбы ISO 7089 под головку и гайку; затяжка 80 Н·м; по желанию фиксатор резьбы средней прочности.
* Широкие шайбы DIN 9021 / ISO 7093 — под гайки на стенках труб 3 мм (стойки руля, стакан шифтера).
* Регулируемые опоры: М12×80, шарнирные, Ø50–60, ≥ 300 кг каждая; контргайка сверху пластины.
* Вкладыши телескопов: лазер из листа 2 мм + запасной комплект 1.5 и 2.5 мм для подбора зазора.
* Приварных гаек в регулировках нет: везде сквозные болты с гайками ISO 7042 (кроме 6 гаек М12 под опоры).
