vlad-anisov/misha/fabrication/laser_parts.csv

pos | part | thickness_mm | size_mm | holes | qty | spec | dxf
Л01 | fin_pedal | 8.0 | 490x50 | 16 | 2 | Лист 8 мм (лазер), гребень 50x490, 16 отв. Ø13 шаг 25 | Л01_fin_pedal_t8.dxf
Л02 | fin_seat | 8.0 | 470x50 | 18 | 2 | Лист 8 мм (лазер), гребень 50x470, 18 отв. Ø13 шаг 25 | Л02_fin_seat_t8.dxf
Л03 | foot_plate | 8.0 | 90x60 | 1 | 6 | Лист 8 мм 60x90, отв. Ø13 (выступает наружу) | Л03_foot_plate_t8.dxf
Л04 | tower_gusset_outer | 8.0 | 439x210 | 10 | 2 | Лист 8 мм, косынка-накладка, 10 отв. Ø13 | Л04_tower_gusset_outer_t8.dxf
Л05 | tower_liner_steel | 2.0 | 373x60 | 10 | 4 | Лист 2 мм ст. (холоднокат., лазер), вкладыш Т-образный 36/60x373, 10 отв. Ø13; подбор 1.5/2.0/2.5 | Л05_tower_liner_steel_t2.dxf
Л06 | tower_liner_x | 2.0 | 378x56 | 0 | 4 | Лист 2 мм ст. (холоднокат., лазер), вкладыш Т-образный 36/56x378, без отв.; подбор 1.5/2.0/2.5 | Л06_tower_liner_x_t2.dxf
Л07 | tower_gusset_inner | 8.0 | 112x45 | 0 | 2 | Лист 8 мм (лазер), косынка 100x50 (ниже гаек нижнего положения) | Л07_tower_gusset_inner_t8.dxf
Л08 | saddle_cheek_welded | 8.0 | 120x89 | 2 | 2 | Лист 8 мм 120x89, вырез под поперечину, 2 отв. Ø13 | Л08_saddle_cheek_welded_t8.dxf
Л09 | saddle_clamp_plate | 8.0 | 120x49 | 2 | 2 | Лист 8 мм 120x49, 2 отв. Ø13, съёмная прижимная | Л09_saddle_clamp_plate_t8.dxf
Л10 | deck_fin | 8.0 | 260x50 | 10 | 2 | Лист 8 мм (лазер), гребень 50x260, 10 отв. Ø13 шаг 25 | Л10_deck_fin_t8.dxf
Л11 | deck_plate | 12.0 | 420x260 | 4 | 1 | Лист 12 мм 420x260, 4 отв. Ø13 под фронтальный кронштейн (отверстия под базу — после выбора базы) | Л11_deck_plate_t12.dxf
Л12 | deck_fm_flange | 8.0 | 330x170 | 4 | 1 | Лист 8 мм (лазер) 170x330, 4 отв. Ø13 — основание фронтального кронштейна | Л12_deck_fm_flange_t8.dxf
Л13 | deck_fm_plate | 8.0 | 300x222 | 0 | 1 | Лист 8 мм (лазер) 300x222 — фронтальная плита (отверстия под базу — после выбора базы) | Л13_deck_fm_plate_t8.dxf
Л14 | deck_fm_gusset | 8.0 | 251x124 | 0 | 2 | Лист 8 мм (лазер), косынка 162x192 | Л14_deck_fm_gusset_t8.dxf
Л15 | pedal_shoe_top | 8.0 | 200x51 | 0 | 2 | Лист 8 мм 200x51 | Л15_pedal_shoe_top_t8.dxf
Л16 | pedal_shoe_cheek | 8.0 | 200x42 | 3 | 4 | Лист 8 мм 200x42, 3 отв. Ø13 (приварная щека = та же деталь, что прижимная) | Л16_pedal_shoe_cheek_t8.dxf
Л17 | pedal_sector_plate | 8.0 | 348x254 | 12 | 2 | Лист 8 мм, щека-сектор, 12 отв. Ø13 | Л17_pedal_sector_plate_t8.dxf
Л18 | pedal_tray_plate | 8.0 | 450x330 | 0 | 1 | Лист 8 мм 450x330 (отв. под педали — по месту) | Л18_pedal_tray_plate_t8.dxf
Л19 | pedal_tray_flange | 8.0 | 330x50 | 2 | 2 | Лист 8 мм (лазер), фланец 50x330, 2 отв. Ø13 | Л19_pedal_tray_flange_t8.dxf
Л20 | seat_shoe_top | 8.0 | 150x40 | 0 | 4 | Лист 8 мм 150x40 | Л20_seat_shoe_top_t8.dxf
Л21 | seat_shoe_cheek | 8.0 | 150x42 | 3 | 8 | Лист 8 мм 150x42, 3 отв. Ø13 (приварная щека = та же деталь, что прижимная) | Л21_seat_shoe_cheek_t8.dxf
Л22 | seat_crossbar_flange | 8.0 | 524x80 | 0 | 2 | Лист 8 мм (лазер) 80x524 — полка поперечины (сверловка под салазки по месту) | Л22_seat_crossbar_flange_t8.dxf
Л23 | seat_adapter_bar | 8.0 | 395x50 | 0 | 2 | Лист 8 мм (лазер) 50x395 — адаптер под салазки (отверстия по месту) | Л23_seat_adapter_bar_t8.dxf
Л24 | seat_end_flange | 8.0 | 116x72 | 4 | 5 | Лист 8 мм (лазер) 116x72, 4 отв. Ø13 — фланец под боковой кронштейн | Л24_seat_end_flange_t8.dxf
Л25 | side_gusset | 8.0 | 95x46 | 0 | 1 | Лист 8 мм (лазер), косынка | Л25_side_gusset_t8.dxf
Л26 | side_liner | 2.0 | 245x60 | 8 | 2 | Лист 2 мм ст. (холоднокат., лазер), вкладыш Т-образный, 8 отв. Ø13 | Л26_side_liner_t2.dxf
Л27 | side_liner_y | 2.0 | 250x56 | 0 | 2 | Лист 2 мм ст. (холоднокат., лазер), вкладыш Т-образный, без отв. | Л27_side_liner_y_t2.dxf
Л28 | side_platform | 8.0 | 300x170 | 0 | 1 | Лист 8 мм 300x170 — платформа шифтера/ручника (отверстия под устройства — по месту) | Л28_side_platform_t8.dxf
Л29 | jig_drill_square40 (кондуктор, не в раму) | 8.0 | 170x40 | 4 | 1 | Лист 8 мм (лазер) — кондуктор сверловки квадратов 40x40 | Л29_jig_drill_square40_t8.dxf
