vlad-anisov/misha/fabrication/cut_list.csv

part | stock | length_mm | qty | note
base_rail | Труба 40x40x3 | 1400 | 2
base_cross | Труба 40x40x3 | 500 | 4
tower_outer_post | Труба 50x50x3 | 418 | 2 | ТРУБОРЕЗ: 10 сквозных отв. Ø13 (оси на 118, 143, 168, 193, 218, 243, 268, 293, 318, 343 мм от низа)
tower_brace | Труба 40x40x3 | 472 | 2 | подкос под 60° к горизонту; торцы: к стойке — плоскость реза под 30° к оси трубы, к лонжерону — под 60° (длина по длинной стороне)
height_inner_post | Квадрат сплошной 40x40 (калиброванный) | 380 | 2 | КАЛИБРОВАННЫЙ квадрат (ГОСТ 8559, h11); 2 отв. Ø13 — сверлильный станок по лазерному кондуктору (см. docs/05)
height_head_cross | Труба 40x40x3 | 570 | 1
pedal_tray_stiffener | Труба 40x40x3 | 434 | 2
seat_crossbar | Труба 50x50x3 | 570 | 2
side_arm | Труба 40x40x3 | 79 | 1
side_cup | Труба 50x50x3 | 305 | 1 | ТРУБОРЕЗ: 8 сквозных отв. Ø13 (оси на 95, 120, 145, 170, 195, 220, 245, 270 мм от низа)
side_bar | Квадрат сплошной 40x40 (калиброванный) | 250 | 1 | КАЛИБРОВАННЫЙ квадрат (ГОСТ 8559, h11); 2 отв. Ø13 — сверлильный станок по лазерному кондуктору (см. docs/05)
