vlad-anisov/misha/fabrication/dxf/Л07_tower_gusset_inner_t8.dxf

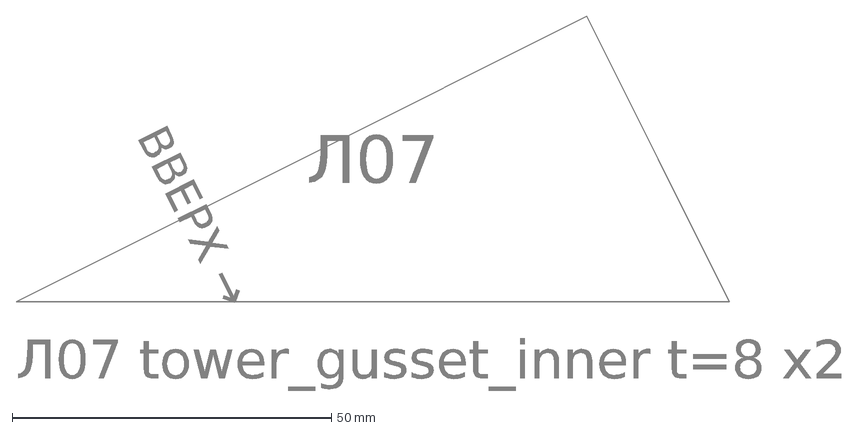
[picture p21: CAD file, 2026-10-11]
fabrication/dxf/Л07_tower_gusset_inner_t8.dxf
Л07 tower_gusset_inner t=8 x2
Л07
ВВЕРХ →
