vlad-anisov/misha/out/step/simrig_wheel_low_fwd_AP214.step

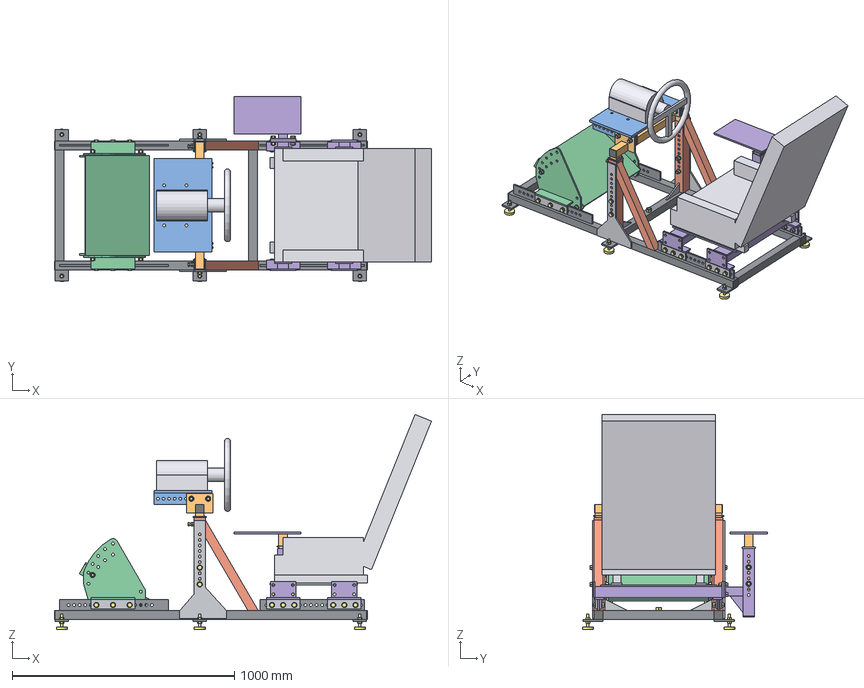
[picture p22: CAD file, 2026-10-11]
out/step/simrig_wheel_low_fwd_AP214.step
1694.8 x 832.8 x 966.6 mm
base_rail_R
base_rail_L
base_cap_R1
base_cap_R2
base_cap_L1
base_cap_L2
base_cross_1
base_cross_2
base_cross_3
base_cross_4
fin_pedal_R
fin_pedal_L
fin_seat_R
fin_seat_L
foot_plate_1_R
foot_plate_1_L
foot_weldnut_1_R
foot_weldnut_1_L
foot_1_R
foot_1_L
foot_plate_2_R
foot_plate_2_L
foot_weldnut_2_R
foot_weldnut_2_L
foot_2_R
foot_2_L
foot_plate_3_R
foot_plate_3_L
foot_weldnut_3_R
foot_weldnut_3_L
foot_3_R
foot_3_L
tower_outer_post_R
tower_outer_post_L
tower_gusset_outer_R
tower_gusset_outer_L
tower_press_weldnut_R
tower_press_weldnut_L
tower_press_screw_R
tower_press_screw_L
tower_liner_steel_in_R
tower_liner_steel_in_L
tower_liner_steel_out_R
tower_liner_steel_out_L
tower_liner_x_front_R
tower_liner_x_front_L
tower_liner_x_rear_R
tower_liner_x_rear_L
tower_brace_R
tower_brace_L
tower_jack_weldnut_M16
tower_gusset_inner_R
tower_gusset_inner_L
height_inner_post_R
height_inner_post_L
height_bolt_1_R
height_bolt_1_L
height_nut_1_R
height_nut_1_L
height_bolt_2_R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
