vlad-anisov/misha/out/stl/simrig_nominal_frame.stl

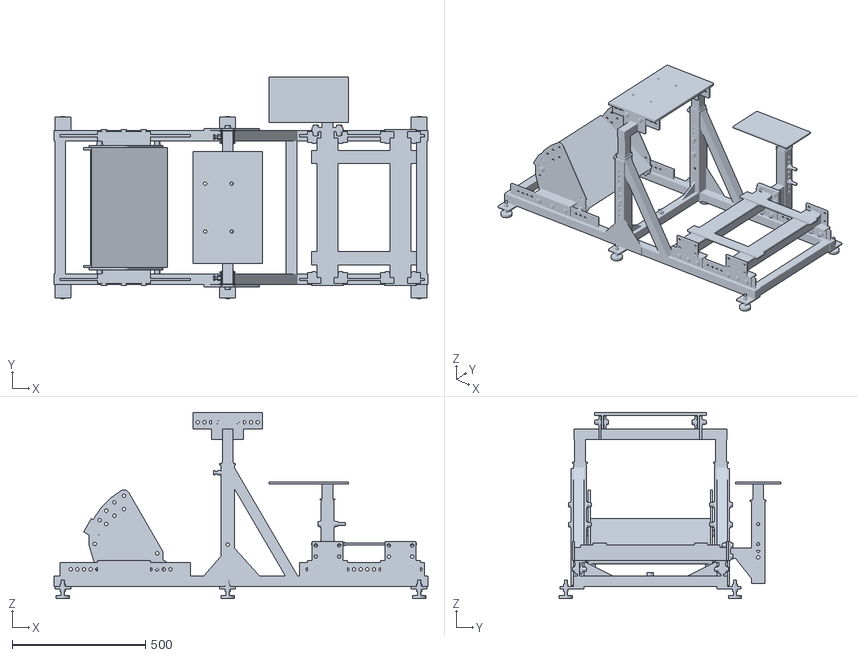
[picture p23: CAD file, 2026-10-11]
out/stl/simrig_nominal_frame.stl
1406.0 x 832.9 x 700.0
