vlad-anisov/misha/fabrication/dxf/Л20_seat_shoe_top_t8.dxf

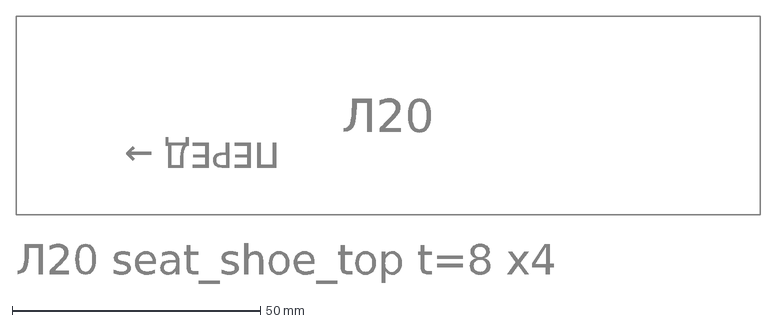
[picture p24: CAD file, 2026-10-11]
fabrication/dxf/Л20_seat_shoe_top_t8.dxf
Л20 seat_shoe_top t=8 x4
Л20
ПЕРЕД →
