vlad-anisov/misha/out/stl/simrig_wheel_low_back.stl

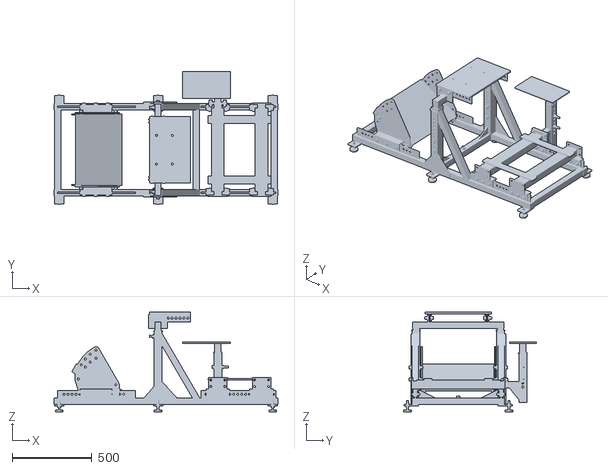
[picture p25: CAD file, 2026-10-11]
out/stl/simrig_wheel_low_back.stl
1406.0 x 832.9 x 625.0
