vlad-anisov/misha/fabrication/dxf/Л25_side_gusset_t8.dxf

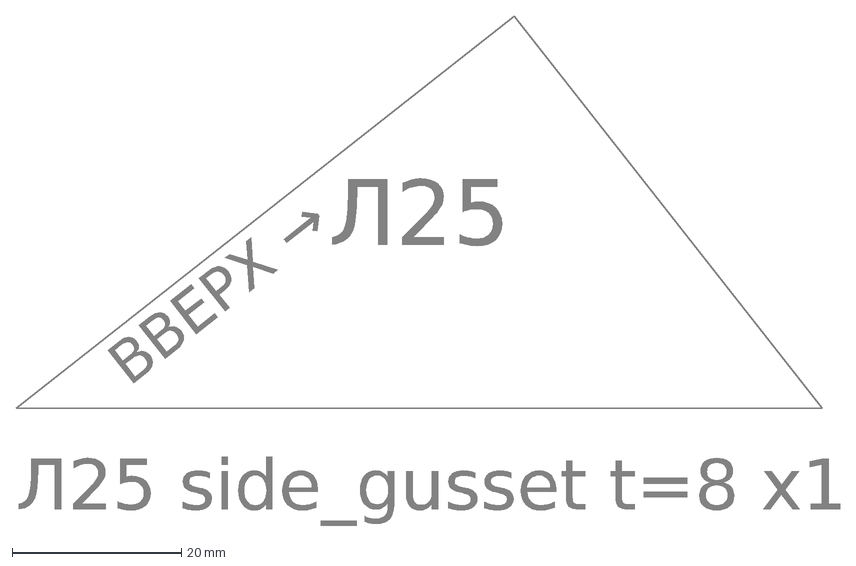
[picture p26: CAD file, 2026-10-11]
fabrication/dxf/Л25_side_gusset_t8.dxf
Л25 side_gusset t=8 x1
Л25
ВВЕРХ →
