vlad-anisov/misha/fabrication/dxf/Л05_tower_liner_steel_t2.dxf

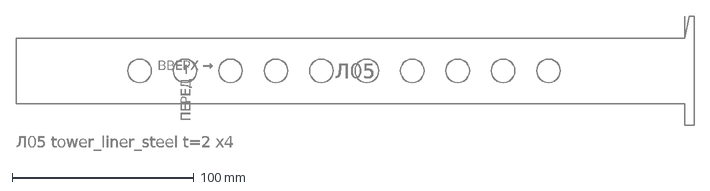
[picture p27: CAD file, 2026-10-11]
fabrication/dxf/Л05_tower_liner_steel_t2.dxf
Л05 tower_liner_steel t=2 x4
Л05
ПЕРЕД →
ВВЕРХ →
