vlad-anisov/misha/fabrication/dxf/Л15_pedal_shoe_top_t8.dxf

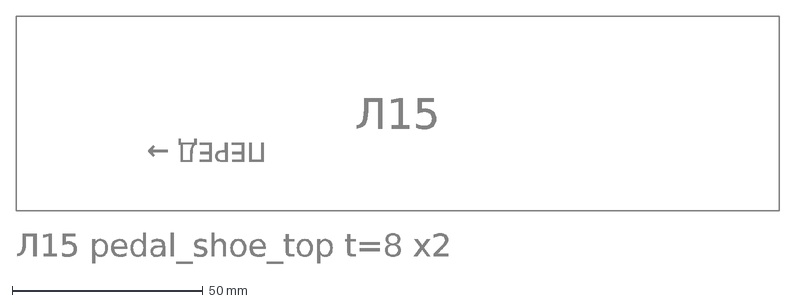
[picture p29: CAD file, 2026-10-11]
fabrication/dxf/Л15_pedal_shoe_top_t8.dxf
Л15 pedal_shoe_top t=8 x2
Л15
ПЕРЕД →
