vlad-anisov/misha/out/stl/simrig_wheel_high_fwd.stl

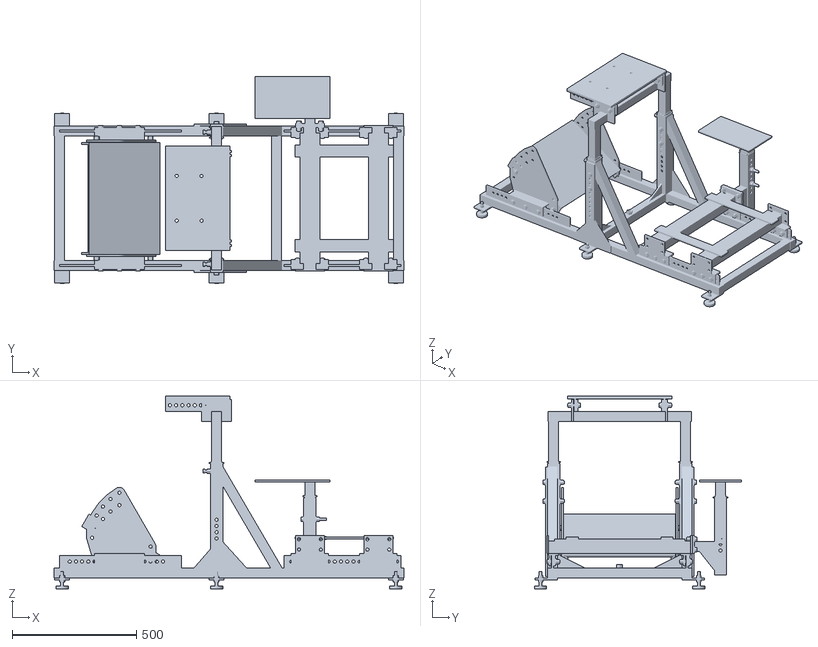
[picture p30: CAD file, 2026-10-11]
out/stl/simrig_wheel_high_fwd.stl
1406.0 x 832.9 x 775.0
