vlad-anisov/misha/fabrication/dxf/Л18_pedal_tray_plate_t8.dxf

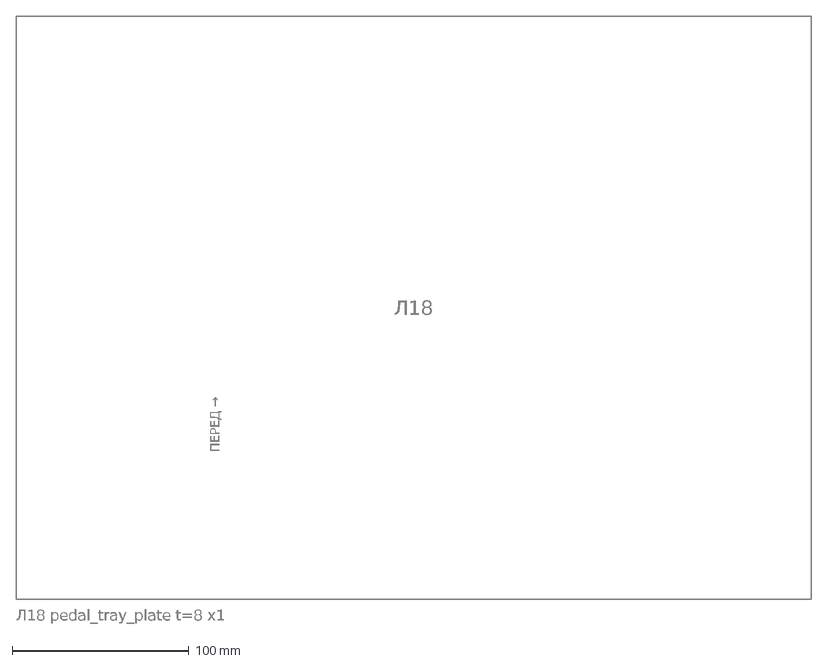
[picture p31: CAD file, 2026-10-11]
fabrication/dxf/Л18_pedal_tray_plate_t8.dxf
Л18 pedal_tray_plate t=8 x1
Л18
ПЕРЕД →
