vlad-anisov/misha/fabrication/dxf/Л23_seat_adapter_bar_t8.dxf

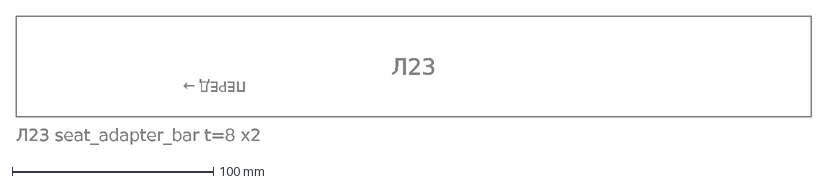
[picture p32: CAD file, 2026-10-11]
fabrication/dxf/Л23_seat_adapter_bar_t8.dxf
Л23 seat_adapter_bar t=8 x2
Л23
ПЕРЕД →
