vlad-anisov/misha/fabrication/dxf/Л01_fin_pedal_t8.dxf

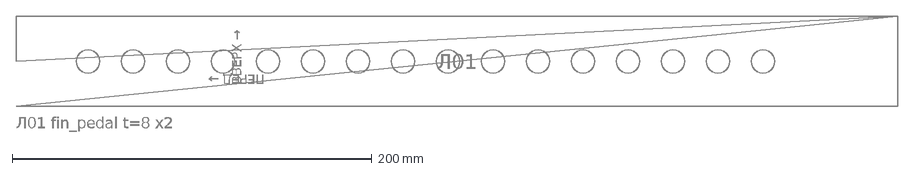
[picture p33: CAD file, 2026-10-11]
fabrication/dxf/Л01_fin_pedal_t8.dxf
Л01 fin_pedal t=8 x2
Л01
ПЕРЕД →
ВВЕРХ →
