vlad-anisov/misha/fabrication/dxf/Л11_deck_plate_t12.dxf

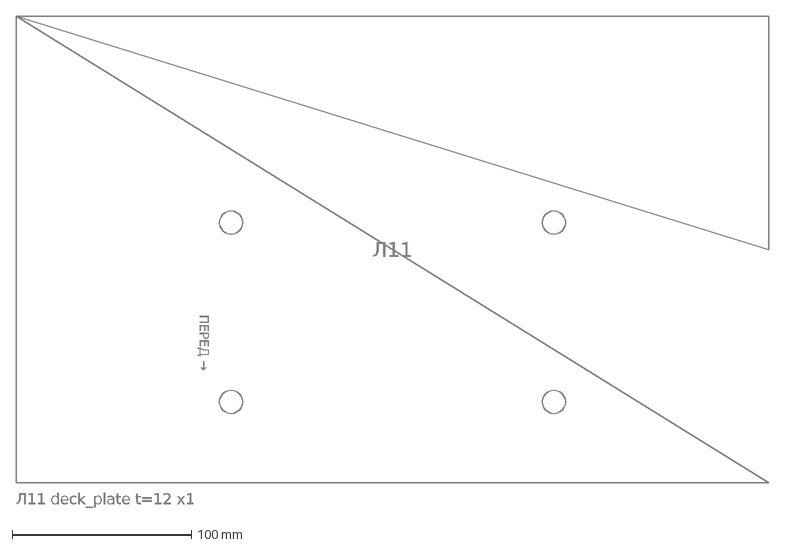
[picture p34: CAD file, 2026-10-11]
fabrication/dxf/Л11_deck_plate_t12.dxf
Л11 deck_plate t=12 x1
Л11
ПЕРЕД →
