vlad-anisov/misha/fabrication/dxf/Л16_pedal_shoe_cheek_t8.dxf

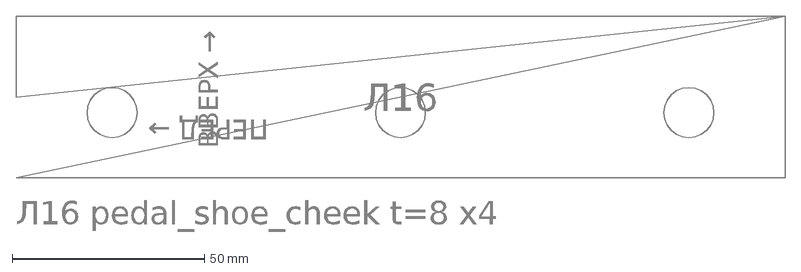
[picture p36: CAD file, 2026-10-11]
fabrication/dxf/Л16_pedal_shoe_cheek_t8.dxf
Л16 pedal_shoe_cheek t=8 x4
Л16
ПЕРЕД →
ВВЕРХ →
