vlad-anisov/misha/fabrication/dxf/Л29_jig_drill_square40_t8.dxf

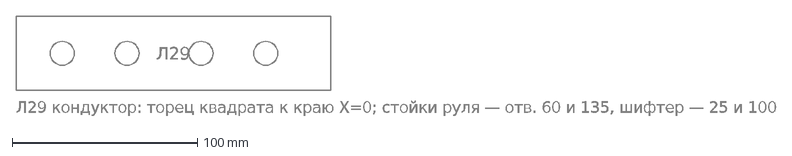
[picture p37: CAD file, 2026-10-11]
fabrication/dxf/Л29_jig_drill_square40_t8.dxf
Л29 кондуктор: торец квадрата к краю X=0; стойки руля — отв. 60 и 135, шифтер — 25 и 100
Л29
