vlad-anisov/misha/fabrication/dxf/Л12_deck_fm_flange_t8.dxf

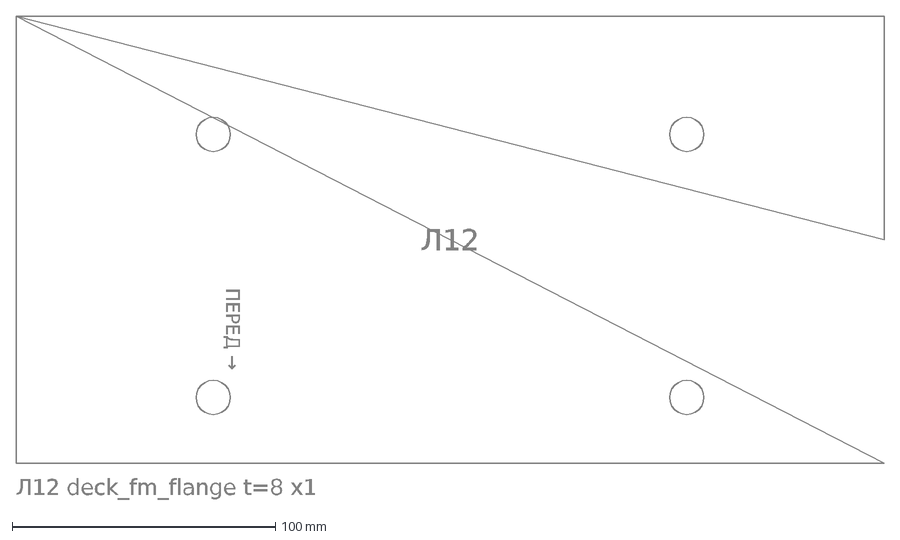
[picture p38: CAD file, 2026-10-11]
fabrication/dxf/Л12_deck_fm_flange_t8.dxf
Л12 deck_fm_flange t=8 x1
Л12
ПЕРЕД →
