vlad-anisov/misha/fabrication/dxf/Л27_side_liner_y_t2.dxf

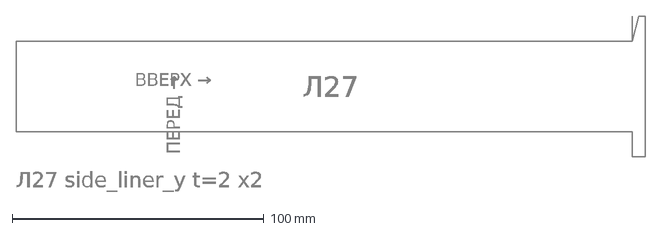
[picture p39: CAD file, 2026-10-11]
fabrication/dxf/Л27_side_liner_y_t2.dxf
Л27 side_liner_y t=2 x2
Л27
ПЕРЕД →
ВВЕРХ →
