vlad-anisov/misha/fabrication/dxf/Л08_saddle_cheek_welded_t8.dxf

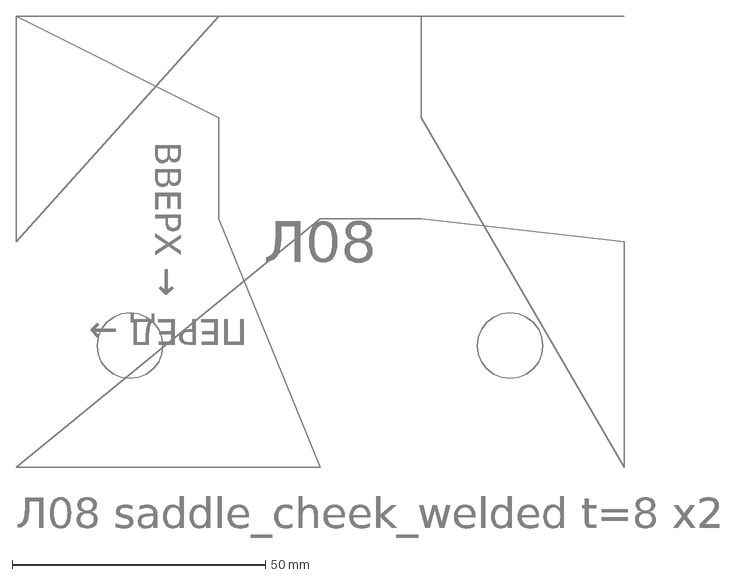
[picture p40: CAD file, 2026-10-11]
fabrication/dxf/Л08_saddle_cheek_welded_t8.dxf
Л08 saddle_cheek_welded t=8 x2
Л08
ПЕРЕД →
ВВЕРХ →
