vlad-anisov/misha/fabrication/dxf/Л06_tower_liner_x_t2.dxf

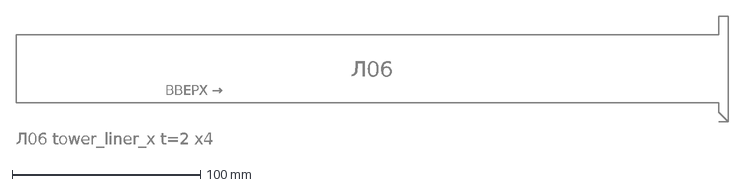
[picture p41: CAD file, 2026-10-11]
fabrication/dxf/Л06_tower_liner_x_t2.dxf
Л06 tower_liner_x t=2 x4
Л06
ВВЕРХ →
