vlad-anisov/misha/fabrication/dxf/Л02_fin_seat_t8.dxf

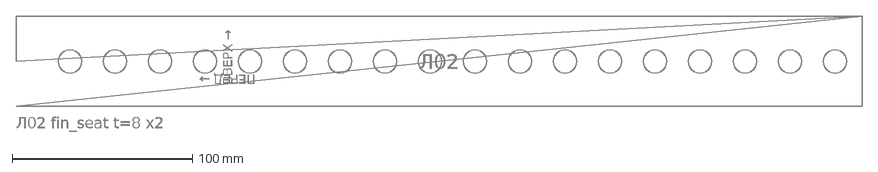
[picture p42: CAD file, 2026-10-11]
fabrication/dxf/Л02_fin_seat_t8.dxf
Л02 fin_seat t=8 x2
Л02
ПЕРЕД →
ВВЕРХ →
