vlad-anisov/misha/fabrication/dxf/Л13_deck_fm_plate_t8.dxf

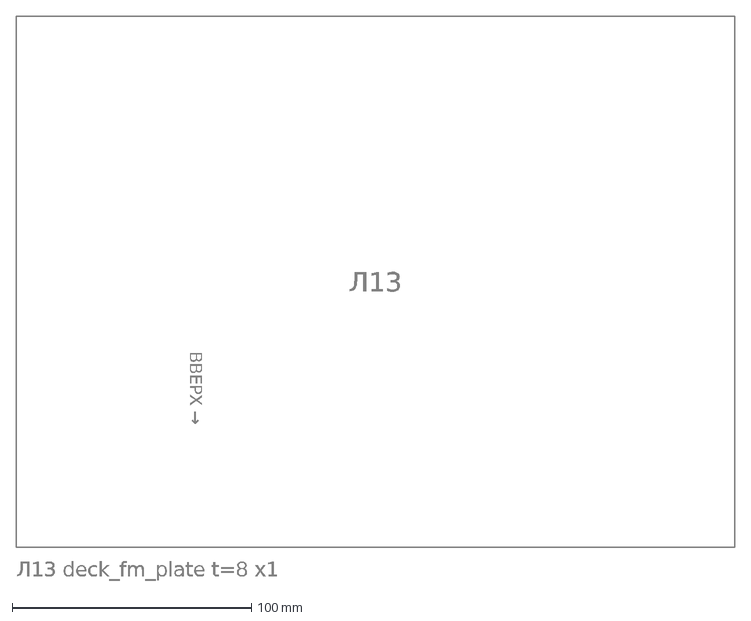
[picture p43: CAD file, 2026-10-11]
fabrication/dxf/Л13_deck_fm_plate_t8.dxf
Л13 deck_fm_plate t=8 x1
Л13
ВВЕРХ →
