vlad-anisov/misha/fabrication/dxf/Л04_tower_gusset_outer_t8.dxf

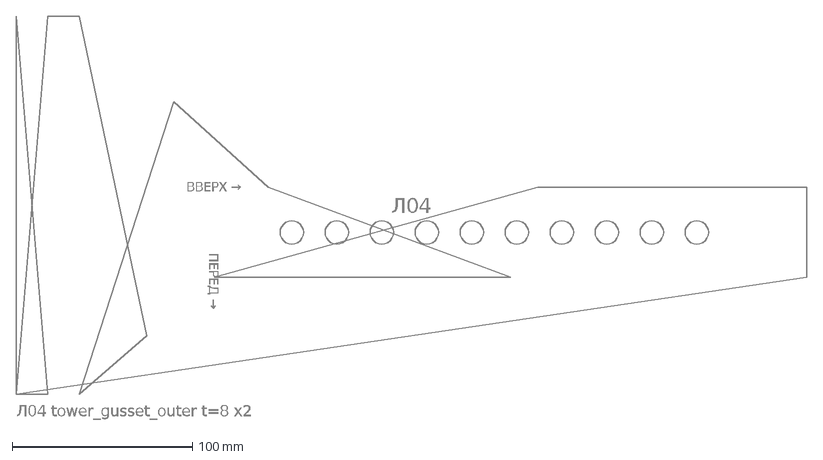
[picture p44: CAD file, 2026-10-11]
fabrication/dxf/Л04_tower_gusset_outer_t8.dxf
Л04 tower_gusset_outer t=8 x2
Л04
ПЕРЕД →
ВВЕРХ →
