vlad-anisov/misha/fabrication/dxf/Л03_foot_plate_t8.dxf

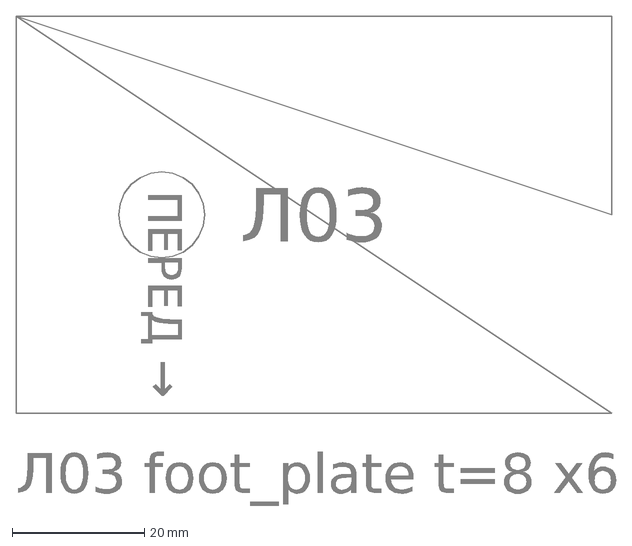
[picture p45: CAD file, 2026-10-11]
fabrication/dxf/Л03_foot_plate_t8.dxf
Л03 foot_plate t=8 x6
Л03
ПЕРЕД →
