vlad-anisov/misha/fabrication/dxf/Л22_seat_crossbar_flange_t8.dxf

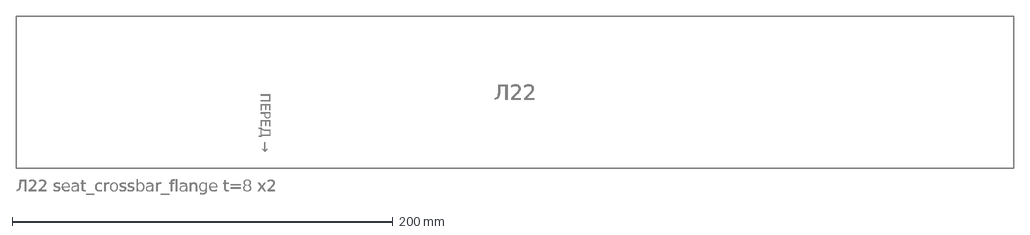
[picture p46: CAD file, 2026-10-11]
fabrication/dxf/Л22_seat_crossbar_flange_t8.dxf
Л22 seat_crossbar_flange t=8 x2
Л22
ПЕРЕД →
