vlad-anisov/misha/fabrication/dxf/Л17_pedal_sector_plate_t8.dxf

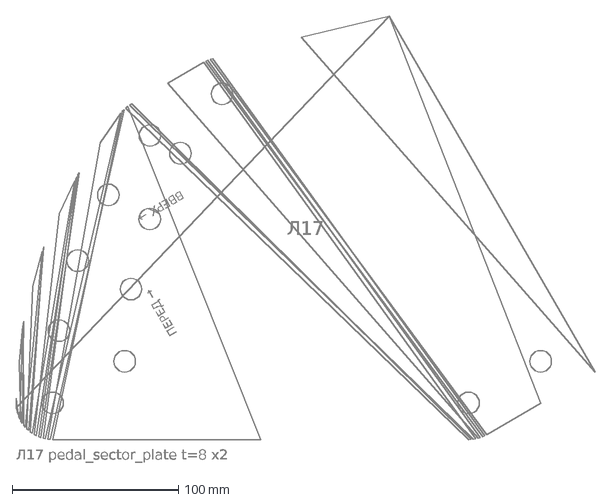
[picture p47: CAD file, 2026-10-11]
fabrication/dxf/Л17_pedal_sector_plate_t8.dxf
Л17 pedal_sector_plate t=8 x2
Л17
ПЕРЕД →
ВВЕРХ →
