vlad-anisov/misha/fabrication/dxf/Л09_saddle_clamp_plate_t8.dxf

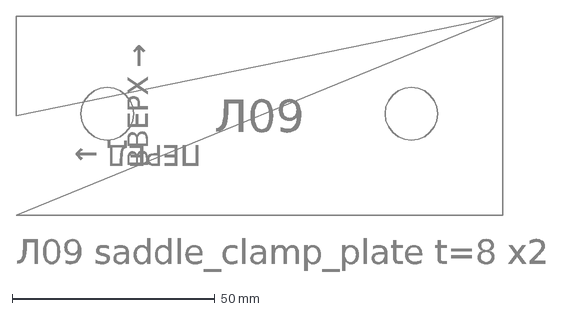
[picture p48: CAD file, 2026-10-11]
fabrication/dxf/Л09_saddle_clamp_plate_t8.dxf
Л09 saddle_clamp_plate t=8 x2
Л09
ПЕРЕД →
ВВЕРХ →
