vlad-anisov/misha/fabrication/dxf/Л14_deck_fm_gusset_t8.dxf

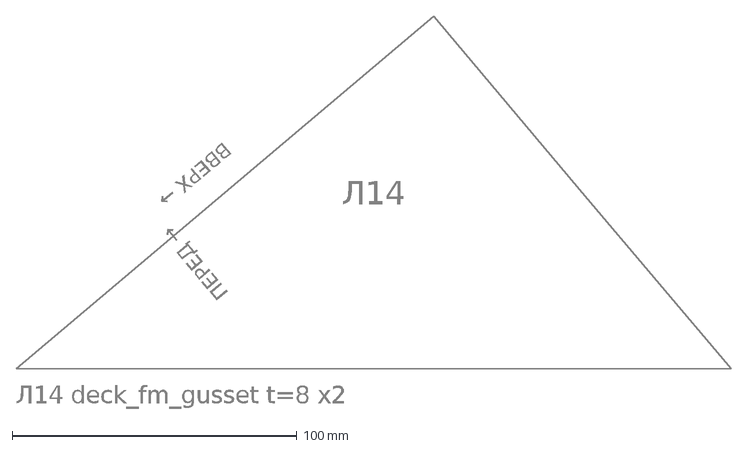
[picture p49: CAD file, 2026-10-11]
fabrication/dxf/Л14_deck_fm_gusset_t8.dxf
Л14 deck_fm_gusset t=8 x2
Л14
ПЕРЕД →
ВВЕРХ →
