vlad-anisov/misha/fabrication/dxf/Л21_seat_shoe_cheek_t8.dxf

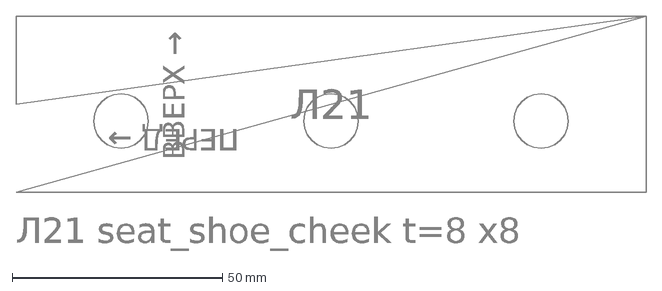
[picture p50: CAD file, 2026-10-11]
fabrication/dxf/Л21_seat_shoe_cheek_t8.dxf
Л21 seat_shoe_cheek t=8 x8
Л21
ПЕРЕД →
ВВЕРХ →
