vlad-anisov/misha/fabrication/dxf/Л26_side_liner_t2.dxf

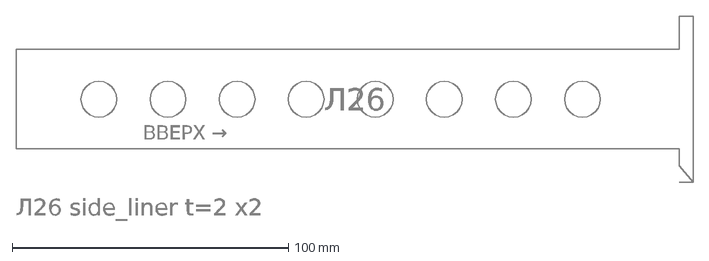
[picture p51: CAD file, 2026-10-11]
fabrication/dxf/Л26_side_liner_t2.dxf
Л26 side_liner t=2 x2
Л26
ВВЕРХ →
