vlad-anisov/misha/fabrication/dxf/Л10_deck_fin_t8.dxf

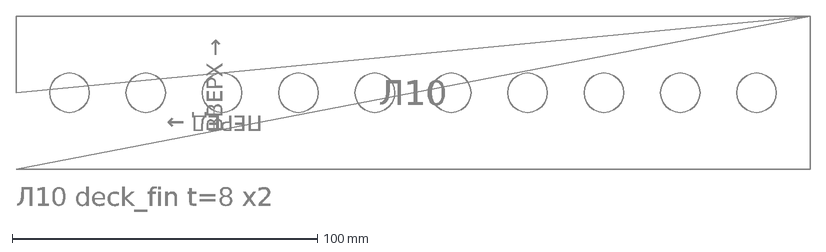
[picture p52: CAD file, 2026-10-11]
fabrication/dxf/Л10_deck_fin_t8.dxf
Л10 deck_fin t=8 x2
Л10
ПЕРЕД →
ВВЕРХ →
