vlad-anisov/misha/fabrication/dxf/Л28_side_platform_t8.dxf

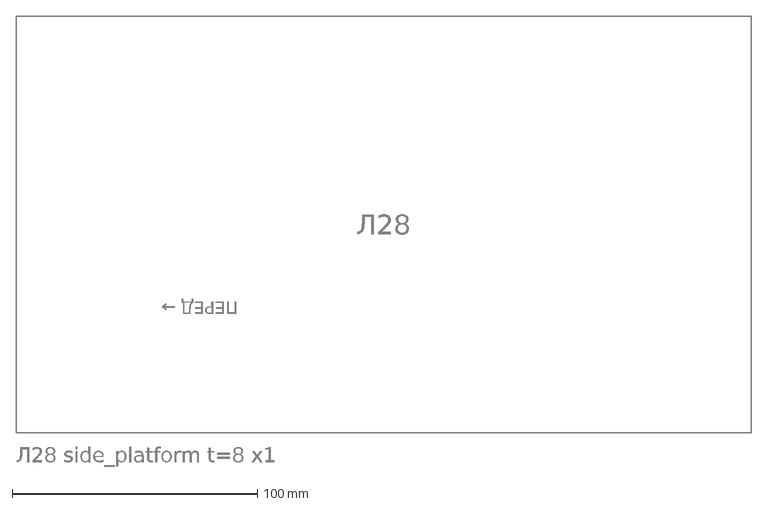
[picture p53: CAD file, 2026-10-11]
fabrication/dxf/Л28_side_platform_t8.dxf
Л28 side_platform t=8 x1
Л28
ПЕРЕД →
