vlad-anisov/misha/fabrication/dxf/Л19_pedal_tray_flange_t8.dxf

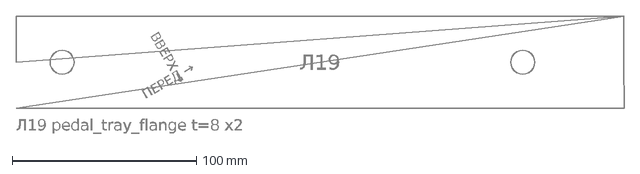
[picture p54: CAD file, 2026-10-11]
fabrication/dxf/Л19_pedal_tray_flange_t8.dxf
Л19 pedal_tray_flange t=8 x2
Л19
ПЕРЕД →
ВВЕРХ →
