vlad-anisov/misha/fabrication/dxf/Л24_seat_end_flange_1R_t8.dxf

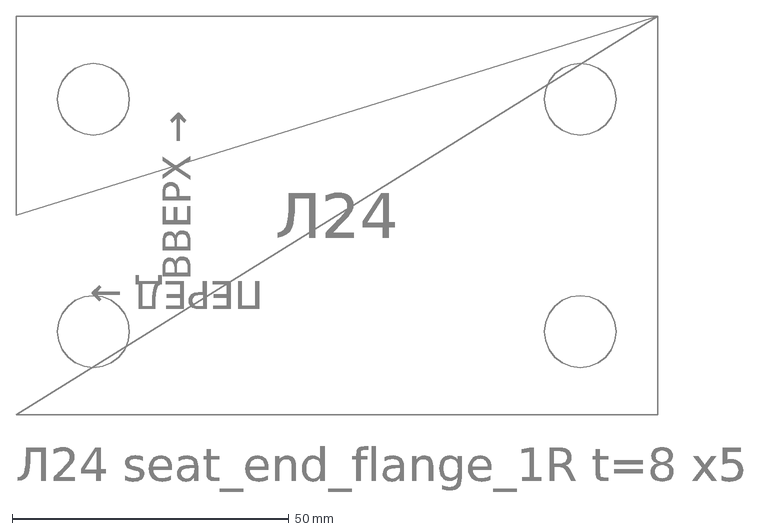
[picture p55: CAD file, 2026-10-11]
fabrication/dxf/Л24_seat_end_flange_1R_t8.dxf
Л24 seat_end_flange_1R t=8 x5
Л24
ПЕРЕД →
ВВЕРХ →
