vlad-anisov/misha/fabrication/dxf/Л11_deck_plate_t8.dxf

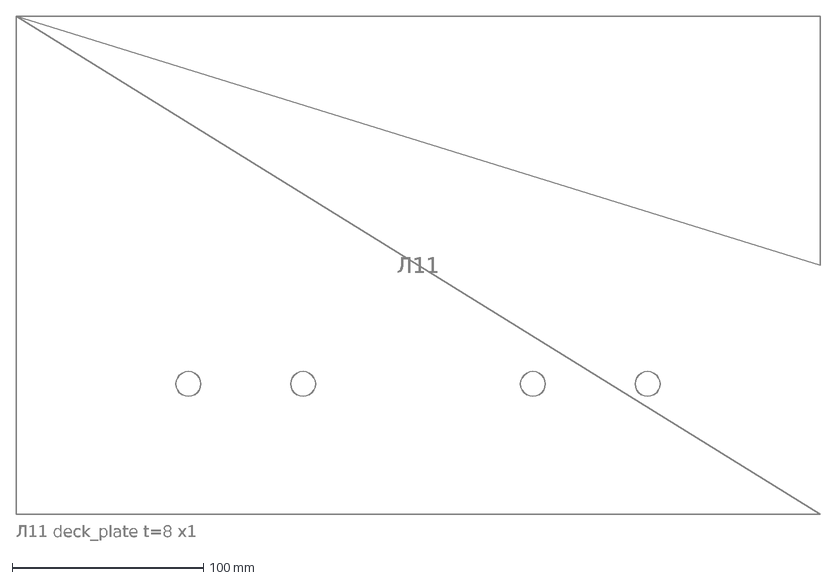
[picture p56: CAD file, 2026-10-11]
fabrication/dxf/Л11_deck_plate_t8.dxf
Л11 deck_plate t=8 x1
Л11
