vlad-anisov/misha/fabrication/dxf/Л24_side_gusset_t8.dxf

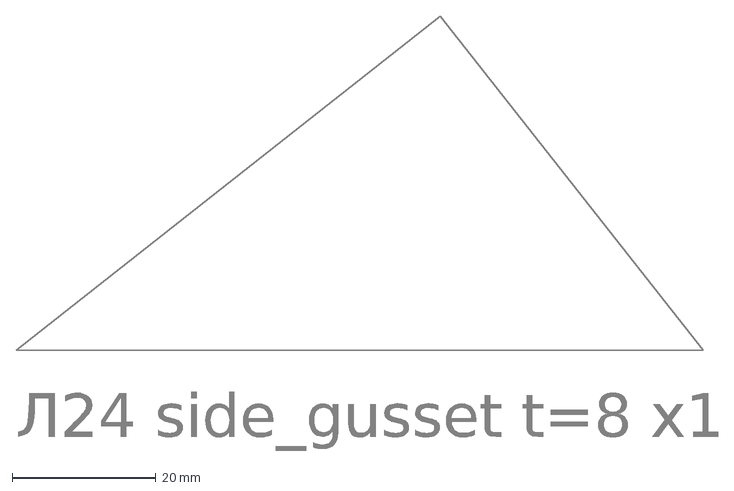
[picture p57: CAD file, 2026-10-11]
fabrication/dxf/Л24_side_gusset_t8.dxf
Л24 side_gusset t=8 x1
