vlad-anisov/misha/fabrication/dxf/Л23_seat_end_flange_t8.dxf

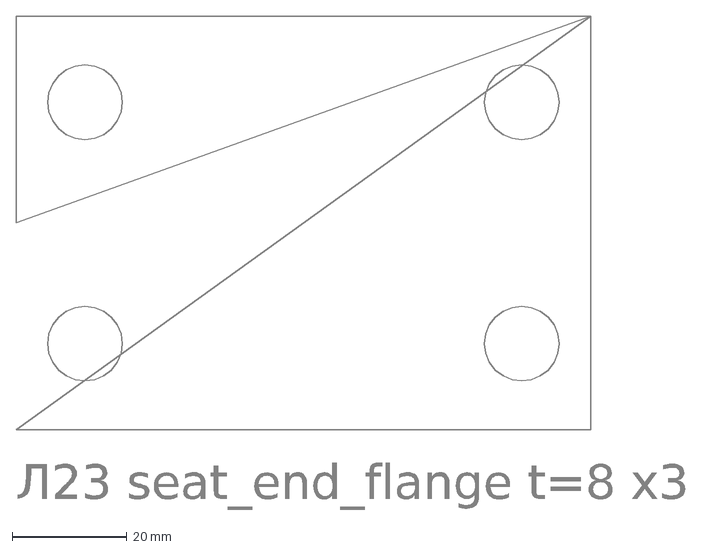
[picture p58: CAD file, 2026-10-11]
fabrication/dxf/Л23_seat_end_flange_t8.dxf
Л23 seat_end_flange t=8 x3
