vlad-anisov/misha/fabrication/dxf/Л19_seat_shoe_top_t8.dxf

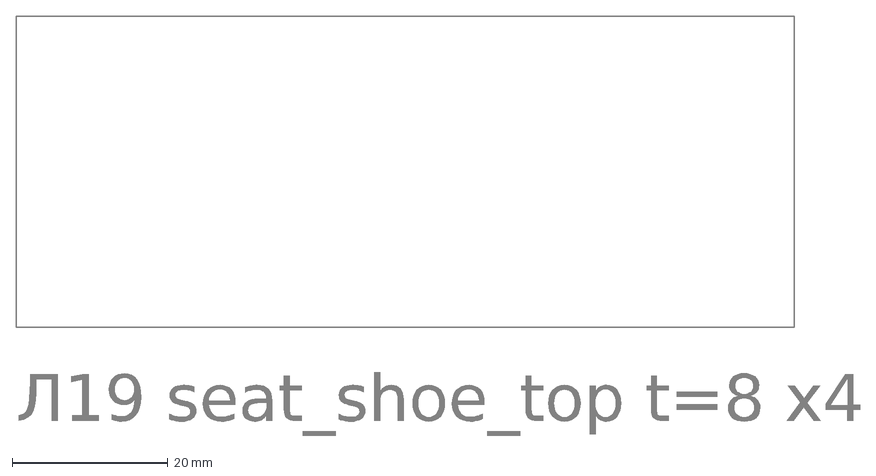
[picture p59: CAD file, 2026-10-11]
fabrication/dxf/Л19_seat_shoe_top_t8.dxf
Л19 seat_shoe_top t=8 x4
