vlad-anisov/misha/fabrication/dxf/Л14_pedal_shoe_top_t8.dxf

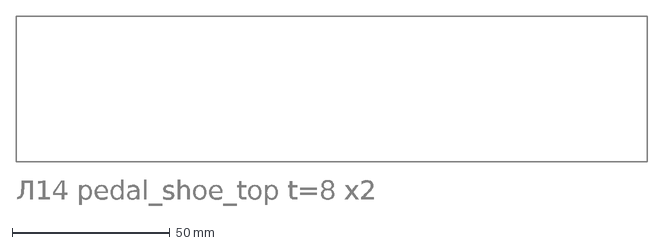
[picture p60: CAD file, 2026-10-11]
fabrication/dxf/Л14_pedal_shoe_top_t8.dxf
Л14 pedal_shoe_top t=8 x2
