vlad-anisov/misha/fabrication/dxf/Л07_saddle_cheek_welded_t8.dxf

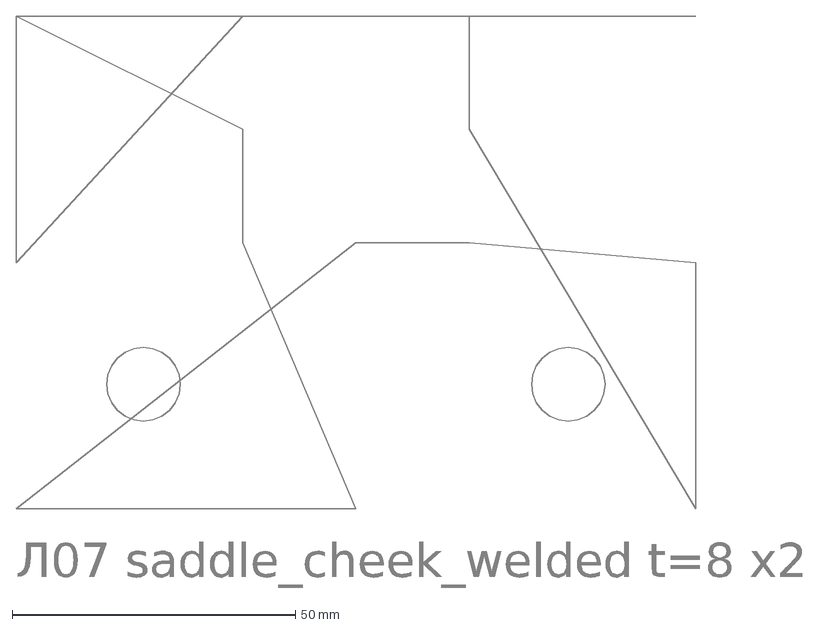
[picture p61: CAD file, 2026-10-11]
fabrication/dxf/Л07_saddle_cheek_welded_t8.dxf
Л07 saddle_cheek_welded t=8 x2
