vlad-anisov/misha/fabrication/dxf/Л13_deck_fm_gusset_t8.dxf

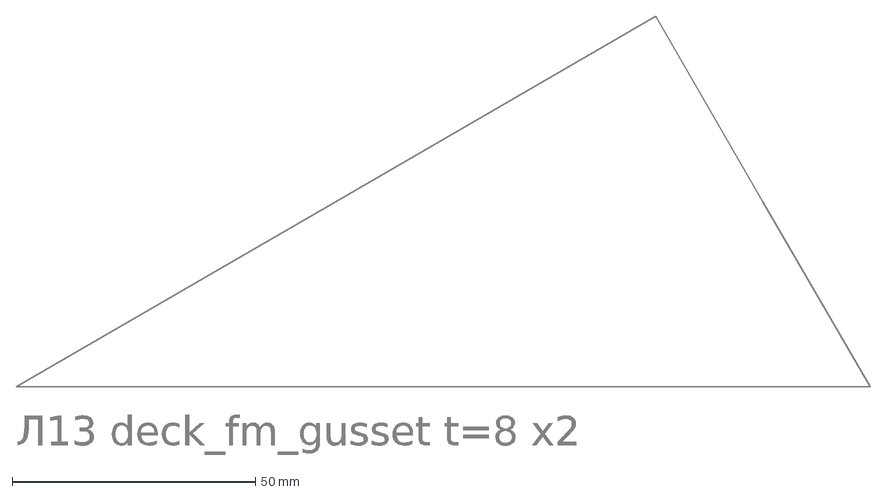
[picture p62: CAD file, 2026-10-11]
fabrication/dxf/Л13_deck_fm_gusset_t8.dxf
Л13 deck_fm_gusset t=8 x2
