vlad-anisov/misha/fabrication/dxf/Л16_pedal_sector_plate_t8.dxf

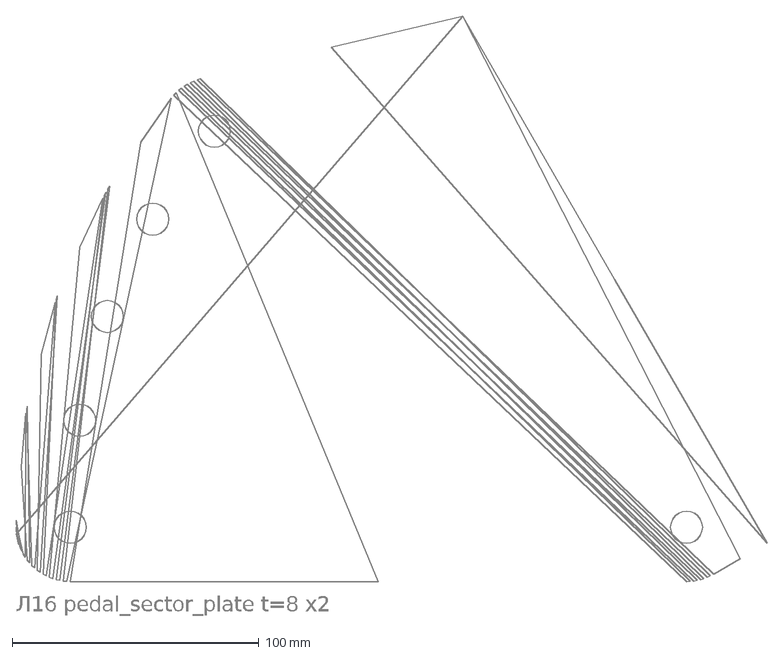
[picture p63: CAD file, 2026-10-11]
fabrication/dxf/Л16_pedal_sector_plate_t8.dxf
Л16 pedal_sector_plate t=8 x2
