vlad-anisov/misha/fabrication/dxf/Л11_deck_fm_flange_t8.dxf

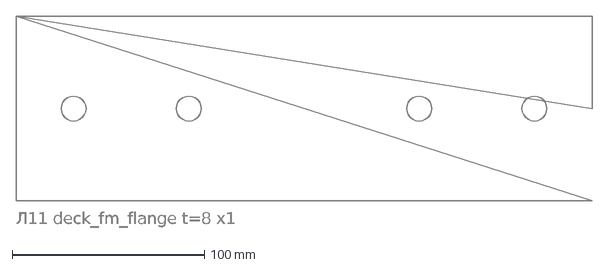
[picture p64: CAD file, 2026-10-11]
fabrication/dxf/Л11_deck_fm_flange_t8.dxf
Л11 deck_fm_flange t=8 x1
