vlad-anisov/misha/fabrication/dxf/Л20_seat_shoe_cheek_t8.dxf

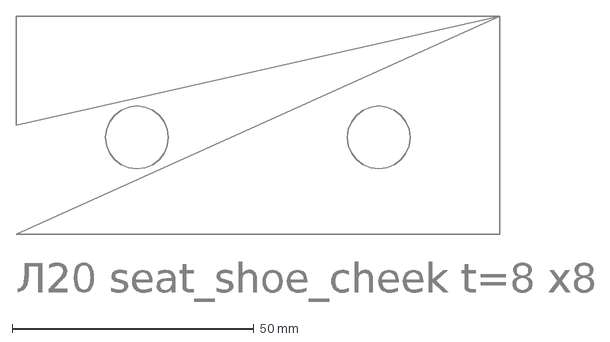
[picture p65: CAD file, 2026-10-11]
fabrication/dxf/Л20_seat_shoe_cheek_t8.dxf
Л20 seat_shoe_cheek t=8 x8
