vlad-anisov/misha/fabrication/dxf/Л17_pedal_tray_plate_t8.dxf

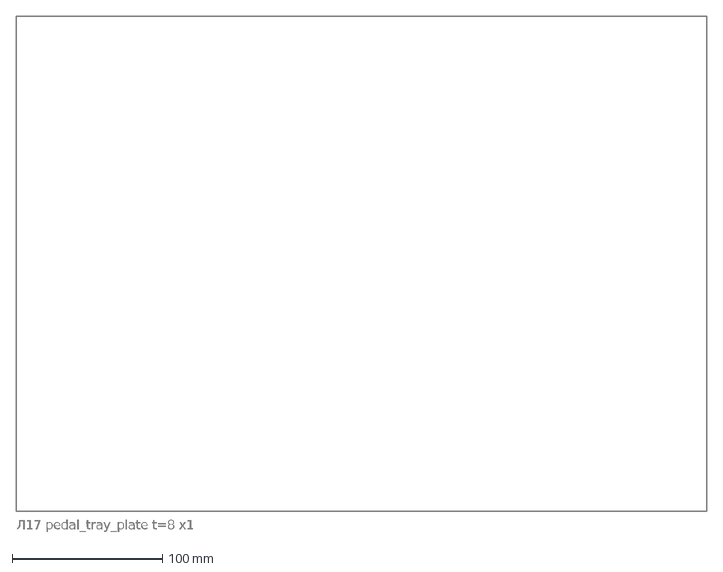
[picture p66: CAD file, 2026-10-11]
fabrication/dxf/Л17_pedal_tray_plate_t8.dxf
Л17 pedal_tray_plate t=8 x1
