vlad-anisov/misha/fabrication/dxf/Л21_seat_crossbar_flange_t8.dxf

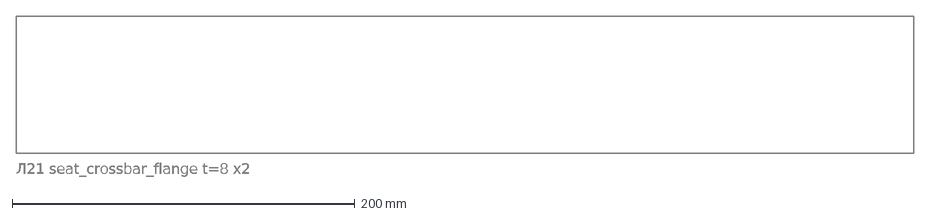
[picture p67: CAD file, 2026-10-11]
fabrication/dxf/Л21_seat_crossbar_flange_t8.dxf
Л21 seat_crossbar_flange t=8 x2
