vlad-anisov/misha/fabrication/dxf/Л15_pedal_shoe_cheek_t8.dxf

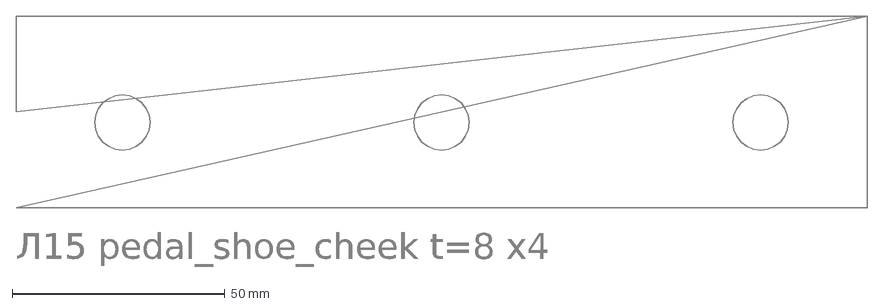
[picture p68: CAD file, 2026-10-11]
fabrication/dxf/Л15_pedal_shoe_cheek_t8.dxf
Л15 pedal_shoe_cheek t=8 x4
