vlad-anisov/misha/fabrication/dxf/Л18_pedal_tray_flange_t8.dxf

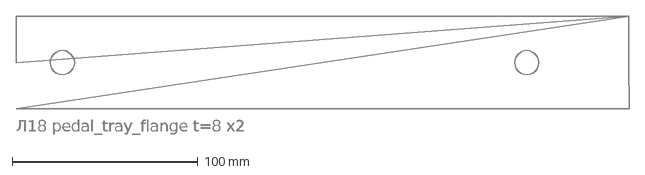
[picture p69: CAD file, 2026-10-11]
fabrication/dxf/Л18_pedal_tray_flange_t8.dxf
Л18 pedal_tray_flange t=8 x2
