vlad-anisov/misha/fabrication/dxf/Л09_deck_fin_t8.dxf

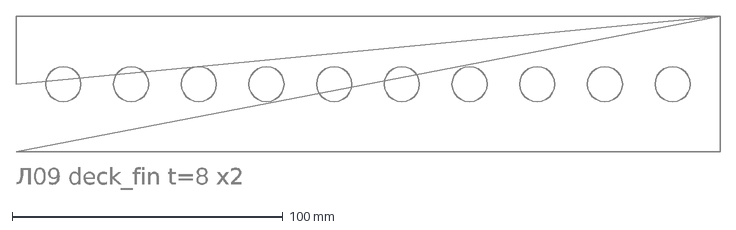
[picture p70: CAD file, 2026-10-11]
fabrication/dxf/Л09_deck_fin_t8.dxf
Л09 deck_fin t=8 x2
