vlad-anisov/misha/fabrication/dxf/Л08_saddle_clamp_plate_t8.dxf

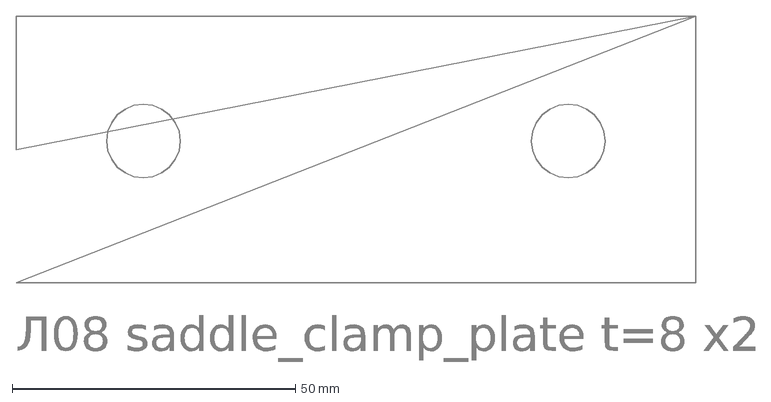
[picture p71: CAD file, 2026-10-11]
fabrication/dxf/Л08_saddle_clamp_plate_t8.dxf
Л08 saddle_clamp_plate t=8 x2
