vlad-anisov/misha/fabrication/dxf/Л06_tower_gusset_inner_t8.dxf

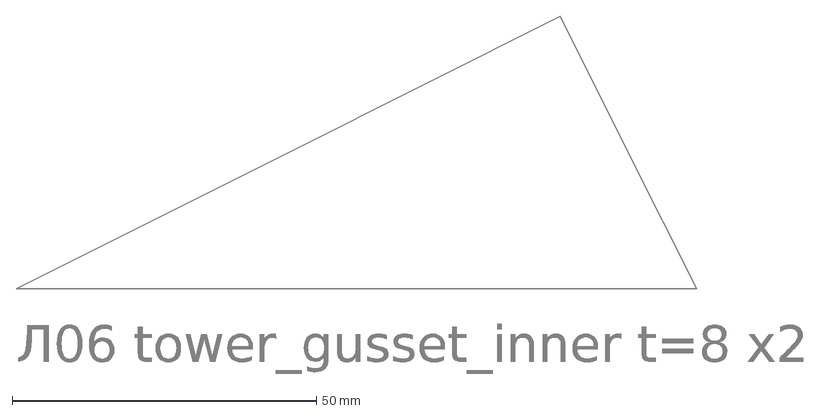
[picture p72: CAD file, 2026-10-11]
fabrication/dxf/Л06_tower_gusset_inner_t8.dxf
Л06 tower_gusset_inner t=8 x2
