vlad-anisov/misha/fabrication/dxf/Л12_deck_fm_plate_t8.dxf

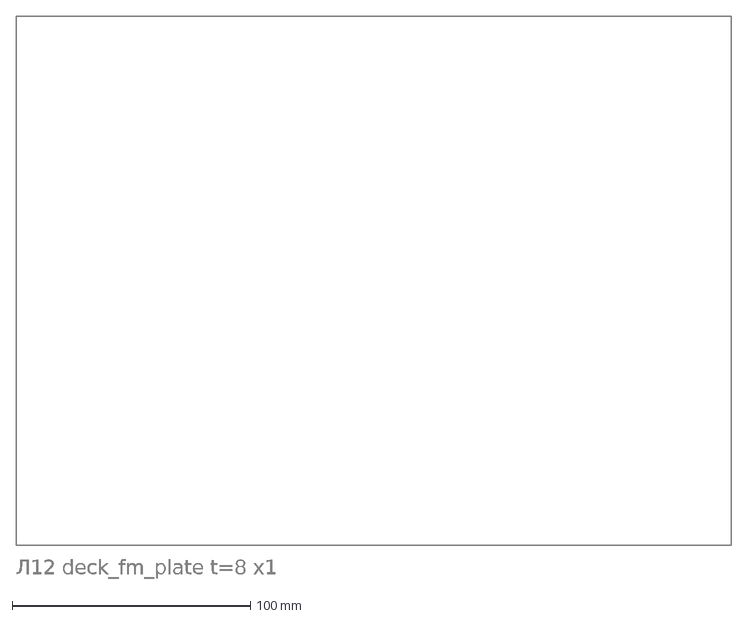
[picture p73: CAD file, 2026-10-11]
fabrication/dxf/Л12_deck_fm_plate_t8.dxf
Л12 deck_fm_plate t=8 x1
