vlad-anisov/misha/fabrication/dxf/Л10_deck_plate_t8.dxf

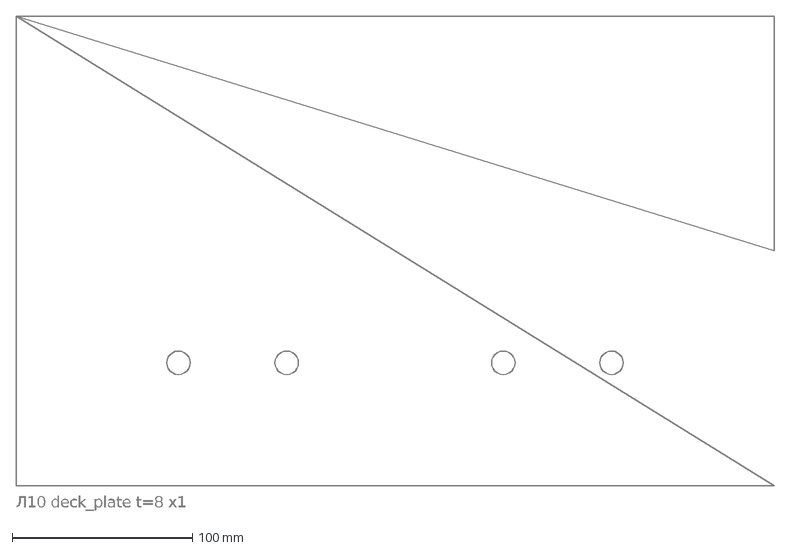
[picture p74: CAD file, 2026-10-11]
fabrication/dxf/Л10_deck_plate_t8.dxf
Л10 deck_plate t=8 x1
