vlad-anisov/misha/fabrication/dxf/Л25_side_liner_t2.dxf

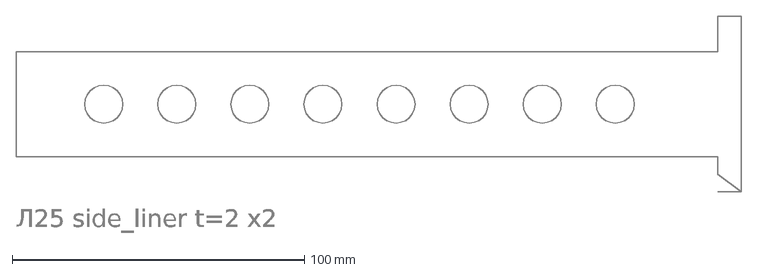
[picture p75: CAD file, 2026-10-11]
fabrication/dxf/Л25_side_liner_t2.dxf
Л25 side_liner t=2 x2
