vlad-anisov/misha/fabrication/dxf/Л26_side_platform_t8.dxf

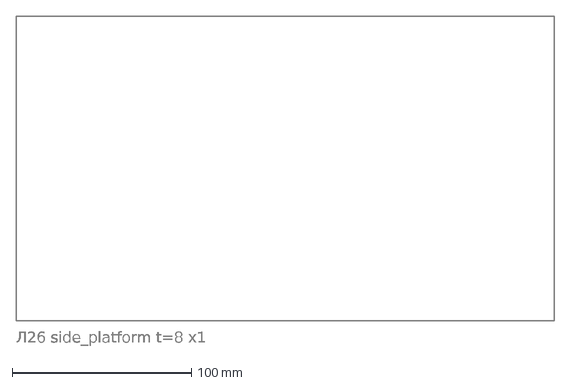
[picture p76: CAD file, 2026-10-11]
fabrication/dxf/Л26_side_platform_t8.dxf
Л26 side_platform t=8 x1
