vlad-anisov/misha/fabrication/dxf/Л22_seat_adapter_bar_t8.dxf

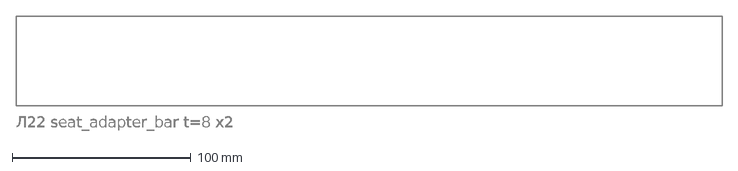
[picture p77: CAD file, 2026-10-11]
fabrication/dxf/Л22_seat_adapter_bar_t8.dxf
Л22 seat_adapter_bar t=8 x2
