vlad-anisov/misha/(list of files, cad)

Other CAD files:
out/step/simrig_wheel_low_back_AP214.step
out/step/simrig_nominal_AP242.step
out/stl/simrig_wheel_low_fwd.stl
out/stl/simrig_nominal_with_refs.stl
out/step/simrig_nominal_AP214.step
out/step/simrig_wheel_high_back_AP214.step
out/stl/simrig_wheel_high_back.stl
