vlad-anisov/misha/docs/05_fabrication_assembly.md

# 5. Изготовление и сборка — инструкция для мастера (ревизия 4)

> **Принцип.** Мастер не размечает и не сверлит точных отверстий. Всё с отверстиями режет лазер (лист) или лазерный
> труборез (3 трубы 50×50). Единственная сверловка — 6 отверстий в калиброванных квадратах 40×40 **на сверлильном
> станке по лазерному кондуктору Л29**. Узлы собираются **на болтах как в кондукторе** и только потом свариваются —
> собранные на болтах детали физически не встанут неправильно.
>
> Таблицы: [`docs/generated/fabrication_tables.md`](generated/fabrication_tables.md) · DXF 1:1 — `fabrication/dxf/`
> (слой CUT — резка; слой MARK — гравировка номера позиции и стрелок «ПЕРЕД →», «ВВЕРХ →») · раскладка —
> `drawings/S12_laser_parts.png`.

## 5.1 Что заказать

| Что | Где | Файлы / примечание |
|---|---|---|
| 28 лазерных позиций + кондуктор Л29: **лист 8 мм** (всё, кроме двух позиций), **лист 12 мм** — только площадка руля Л11, **лист 2 мм обычной стали (холоднокатаный)** — вкладыши Л05, Л06, Л26, Л27 | лазерный цех | `fabrication/dxf/*.dxf`; гравировка слоя MARK |
| Вкладыши — **дополнительно комплект 1.5 и 2.5 мм** (стандартные толщины листа) (по 4 шт. Л05 и Л06, по 2 шт. Л26 и Л27) | тот же цех | подбор зазора телескопов |
| +4 шт. Л23 (полосы 50×395) — проставки для высоты/наклона сиденья | тот же цех | — |
| Наружные стойки 50×50×3 L=418 ×2 (10 отв. Ø13 + 1 отв. Ø10.5) и стакан 50×50×3 L=305 ×1 (8 отв. Ø13) | лазерный труборез | `fabrication/cut_list.csv` |
| Прокат: **труба 40×40×3** (~7.3 м), **труба 50×50×3** (~2.3 м), **квадрат 40×40 калиброванный** (ГОСТ 8559, h11; ~1.0 м; если нет — горячекатаный, зазор выбирается вкладышами 1.5/2.0/2.5) | металлобаза | `fabrication/cut_list.csv`; квадраты и вкладыши — оцинковать или смазать, не красить |
| Крепёж: болты М12×40 / ×45 / ×90 кл. 8.8 оцинк. (ISO 4014, с гладкой частью), гайки ISO 7042 М12 (**+ запас 30 шт. на замену**), шайбы ISO 7089 и DIN 9021; 6 гаек М12 и 2 гайки М10 под приварку, гайка М16 под приварку; винты М10×30 + контргайки (2); 6 шарнирных опор М12×80 Ø50 + контргайки; пластиковые заглушки 40×40 и 50×50 | крепёж | `docs/generated/bom.md` |
| Инструмент-оснастка (не в раму): шпилька М16×700 с гайкой/воротком — съёмный домкрат для перестановки высоты руля | — | — |

## 5.2 Допуски и сварка

| Параметр | Требование |
|---|---|
| Отверстия Ø13 (лазер, труборез) | Ø13 +0.2/−0, без окалины; позиция ±0.2 |
| Длины резки труб | ±1 мм; торцы под 90° (кроме подкосов) |
| Основание | диагонали — разница ≤ 2 мм |
| **Гребни** | расстояние между внутренними гранями левого и правого гребня **532 −0/+3 мм** по всей длине; одноимённые отверстия левого и правого гребня — по X **±0.5 мм** |
| Стойки руля | параллельность ≤ 0.5 мм на 300 мм; перпендикулярность к основанию ≤ 1 мм на 300 мм |
| Катет швов | 3–4 мм (у гребней — не более 5 мм: щёки башмаков начинаются на 8 мм выше лонжерона); MIG/MAG или электрод |

**Карта сварки**

| Соединение | Шов |
|---|---|
| Рамка основания, стойки к лонжеронам, подкосы, верхняя поперечина к квадратам, консоль/стакан шифтера, платформа | сплошной по контуру |
| Косынки Л04 | **прерывистый 40/40 с обеих сторон, вразбежку** (против поводки стойки), торцы — сплошные |
| Косынки Л07, Л14, Л25 | сплошной |
| Гребни Л01, Л02 к лонжеронам | участки 30/50 с двух сторон + сплошные обварки 30 мм на торцах |
| Гребни Л10 к листу Л11 | участки 40/40 с двух сторон, торцы — сплошные |
| Внутренняя щека башмака (Л16, Л21) к верхней пластине (Л15, Л20) | прихватка на гребне (на болтах), затем сплошной на столе — **на болтах, в собранном виде** |
| Щёки сёдел Л08 к верхней поперечине | прихватка на месте, доварка со снятой площадкой (брызги не попадут на гребень) |
| Фланцы Л19 к листу Л18, рёбра 40×40×3 к фланцам | сплошной |
| Гайки под приварку (М12 опор, М10 прижимов, М16 домкрата) | с вкрученным болтом (резьба защищена от брызг) |
| **Не варить:** прижимные пластины (Л09, наружные Л16 и Л21), вкладыши, квадраты 40×40 к стойкам | — |

Доварку узлов, снятых после прихватки, вести **в собранном на болтах виде** (детали прикручены к ответным) и после
остывания проверить, что болты проходят свободно.

## 5.3 Порядок сборки

**Шаг 1. Основание**
1. Лонжероны 40×40×3 L=1400 ×2 и 4 поперечины 40×40×3 L=500 — прихватить, проверить диагонали, обварить.
2. Пластины опор Л03 — под лонжерон, **отверстием наружу** рамы; гайку М12 приварить снизу (с вкрученным болтом).
3. Гайка М16 — на верхнюю грань поперечины под стойками (X = 650) по центру рамы (с вкрученным болтом).

**Шаг 2. Квадраты 40×40** — сверлильный станок, кондуктор Л29: торец квадрата в уровень с краем кондуктора,
струбцина. Стойки руля (L=380 ×2): отверстия «60» и «135»; квадрат шифтера (L=250): «25» и «100».

**Шаг 3. П-узел высоты — сварить ПОЛНОСТЬЮ до установки стоек**
1. В наружные стойки (ещё не приваренные) вставить вкладыши Л05/Л06 (подобрать: квадрат входит от руки без качки)
   и квадраты; 4 болта М12×90. Положить верхнюю поперечину 40×40×3 L=570 на торцы квадратов, прихватить.
2. Вынуть болты, снять П-узел, **полностью обварить** поперечину к квадратам на столе, дать остыть.

**Шаг 4. Рулевые стойки — по готовому П-узлу**
1. Вставить остывший П-узел в наружные стойки с вкладышами, 4 болта затянуть. Узел целиком поставить на лонжероны:
   X = 650, наружная грань стойки заподлицо с лонжероном, отверстия трубореза — **поперёк рамы**, шов трубы — на
   переднюю/заднюю грань.
2. Прихватить стойки к лонжеронам. Косынки Л04 снаружи (стрелки «ПЕРЕД», «ВВЕРХ») — на 2 болтах через отверстия;
   Л07 — изнутри на поперечину основания. Проверить параллельность и вертикальность, обварить (Л04 — прерывисто).
3. Подкосы 40×40×3 (резы — в таблице раскроя) — от задней грани стойки к лонжерону (X ≈ 890).
4. Приварить гайки М10 прижимов на переднюю грань стоек (с вкрученным винтом).

**Шаг 5. Гребни основания — с поперечинами как кондуктором**
1. Гребень педалей Л01 — от переднего торца X 20…510; гребень сиденья Л02 — X 920…1390, по центру лонжеронов.
2. **Кондуктор:** положить гребни на лонжероны (не приваривая), на гребни сиденья прикрутить башмаки обеих
   поперечин в крайних положениях и прихватить на них поперечины (шаг 8.1–8.2); на гребни педалей — обе каретки
   (шаг 7.1, сектор можно позже). Только в таком виде прихватить гребни к лонжеронам. Проверить 532 −0/+3 между
   внутренними гранями. Снять поперечины/каретки, обварить гребни, затем доварить поперечины и каретки.

**Шаг 6. Площадка руля и сёдла**
1. Площадка: лист 12 мм Л11 + 2 гребня Л10 (оси через 360 мм) — сварить.
2. П-узел на место. Площадку гребнями на верхнюю поперечину; щёки Л08 снаружи гребней (с зазором до 1 мм),
   прижимные Л09 изнутри, по 2 болта М12×45 — затянуть. Прихватить щёки к поперечине → снять площадку →
   доварить щёки.
3. Фронтальный кронштейн (при фронтальном креплении базы): Л12 + Л13 + 2 × Л14 — сварить; ставится 4 болтами
   М12×40 через готовые отверстия площадки (2 ряда).

**Шаг 7. Педальный узел** (может выполняться до шага 5 — каретки служат кондуктором гребней)
1. Каретка (×2, зеркально): на гребне — две Л16 по сторонам гребня, 3 болта М12×45 головкой **наружу**, сверху Л15
   (широкой частью внутрь рамы). Прихватить Л15 к **внутренней** Л16; приставить сектор Л17 (стрелки «ПЕРЕД»,
   «ВВЕРХ»), прихватить. Снять, доварить на болтах (наружная Л16 — съёмная, используется как прижим).
2. Площадка: Л18 + фланцы Л19 + 2 ребра 40×40×3. Фланцы ставить по секторам: ось и болт дуги — М12×40 **головкой
   изнутри площадки**; зазор фланец–сектор до 1 мм выбирается шайбами; затем прихватывать фланцы к листу.

**Шаг 8. Поперечины сиденья (обе одинаковые)**
1. Башмаки (×4): на гребне сиденья две Л21, 3 болта М12×45 головкой наружу, сверху Л20; прихватить Л20 к внутренней Л21.
2. Поперечины 50×50×3 L=570 — на башмаки, сварить. Полки Л22 — сверху. **На оба торца каждой поперечины** —
   фланцы Л24.
3. Адаптерные полосы Л23 не варить; отверстия под салазки — по самим салазкам как по шаблону.

**Шаг 9. Кронштейн шифтера/ручника** — ответный фланец Л24 на 4 болтах к фланцу любой поперечины; к нему консоль
40×40×3 L=79, стакан (отверстия — **вдоль рамы**), косынка Л25 (под задней стенкой консоли); вкладыши Л26/Л27,
квадрат L=250 (по Л29), 2 болта М12×90; платформа Л28 — на торец квадрата.

**Шаг 10. Покраска, сборка, затяжка**
* Порошок или грунт + эмаль. **Не красить** зажимаемые поверхности (гребни, щёки, прижимные пластины, вкладыши,
  квадраты) — маскировать. Подобранные вкладыши приклеить к стенкам стоек (эпоксид/двусторонний скотч).
* Затяжка М12 8.8 — **80 Н·м** динамометрическим ключом, метка краской; повторно через 2–5 часов езды, далее
  раз в 3 месяца. **Гайки ISO 7042 в регулировках менять каждые ~5 перестановок.**
* Ключи: торцевая головка 18 мм; **рожковый 18 мм** — для гаек оси/дуги педалей, гаек кареток педалей и фланца
  кронштейна (проверено по модели).
* Перестановка высоты руля — одним человеком домкратным винтом М16 (`02_adjustable_joints.md` §2.1).

## 5.4 Типичные ошибки и как они исключены

| Ошибка | Как исключено |
|---|---|
| Шаг 25 мм в гребнях «уехал» | Отверстия режет лазер |
| Ряды отверстий в стойках не соосны | Труборез; косынки ставятся на болтах |
| Поперечины сиденья/каретки заклинивает | Щёки с зазором 1 мм + прижимная пластина; гребни варятся с поперечинами как кондуктором; допуск 532 −0/+3 |
| Телескоп не ходит | Калиброванный квадрат; П-узел сваривается до стоек, стойки ставятся по нему; вкладыши 1.5/2.0/2.5 мм; прижим М10 |
| Отверстия в квадратах «ушли» | Станок + кондуктор Л29 |
| Болт нельзя вынуть для регулировки | Проверено по модели для всех болтов во всех 16 конфигурациях |
| Перепутать трубу 2 и 3 мм, толщины листа | Вся труба 40×40 — 3 мм; лист 8 мм везде, кроме Л11 (12 мм) и вкладышей (2 мм) |
| Перепутать щеку и прижимную пластину | Это одна и та же деталь (Л16, Л21) |
| Перевернуть / зеркально поставить деталь | Гравировка номера и стрелок «ПЕРЕД →», «ВВЕРХ →» на каждой лазерной детали |

Ориентировочная трудоёмкость при готовых лазерных деталях и трубах с трубореза: **15–20 часов** (с учётом
подгонки телескопа и выставления гребней по кондуктору).
