vlad-anisov/misha/docs/generated/calc_results.md

# Результаты предварительного расчёта (генерируется calc/frame_fem.py)

> Оценочный расчёт концепции. Стыки приняты жёсткими, податливость сварных узлов, стенок труб и пола не учтена — реальные перемещения ожидаются в 1.5–3 раза больше. После выбора руля пересчитать с его массой, моментом и положением обода.

## Перемещение центра обода (стержневая МКЭ-модель)

| H, мм | d, мм | Нагрузка | dX, мм | dY, мм | dZ, мм | поворот X, ° | поворот Y, ° | σmax, МПа | где |
|---|---|---|---|---|---|---|---|---|---|
| 700 | +0 | LC1 вертикально вниз 1000 Н на ободе (опора рукой при посадке) | +0.56 | +0.00 | -0.51 | -0.000 | +0.127 | 23 | гребень площадки 50x8 |
| 700 | +0 | LC2 к пилоту 500 Н (тянет руль на себя) | +0.58 | +0.00 | -0.28 | -0.000 | +0.081 | 17 | лонжерон основания |
| 700 | +0 | LC3 от пилота 500 Н (упор в руль при торможении) | -0.58 | -0.00 | +0.28 | +0.000 | -0.081 | 17 | лонжерон основания |
| 700 | +0 | LC4 момент базы 25 Н·м + поперечно 300 Н | +0.00 | +0.23 | -0.00 | +0.002 | +0.000 | 10 | верхняя поперечина 40x40x3 |
| 700 | +0 | LC5 вверх 600 Н | -0.33 | -0.00 | +0.30 | +0.000 | -0.076 | 14 | гребень площадки 50x8 |
| 775 | +75 | LC1 вертикально вниз 1000 Н на ободе (опора рукой при посадке) | +0.89 | +0.00 | -0.90 | +0.000 | +0.183 | 28 | гребень площадки 50x8 |
| 775 | +75 | LC2 к пилоту 500 Н (тянет руль на себя) | +0.76 | -0.00 | -0.45 | -0.000 | +0.095 | 19 | лонжерон основания |
| 775 | +75 | LC3 от пилота 500 Н (упор в руль при торможении) | -0.76 | +0.00 | +0.45 | +0.000 | -0.095 | 19 | лонжерон основания |
| 775 | +75 | LC4 момент базы 25 Н·м + поперечно 300 Н | -0.00 | +0.31 | -0.00 | +0.003 | -0.000 | 12 | верхняя поперечина 40x40x3 |
| 775 | +75 | LC5 вверх 600 Н | -0.54 | -0.00 | +0.54 | -0.000 | -0.110 | 17 | гребень площадки 50x8 |
| 625 | -75 | LC1 вертикально вниз 1000 Н на ободе (опора рукой при посадке) | +0.31 | +0.00 | -0.24 | -0.000 | +0.080 | 18 | лист площадки 12 мм |
| 625 | -75 | LC2 к пилоту 500 Н (тянет руль на себя) | +0.44 | +0.00 | -0.16 | -0.000 | +0.068 | 15 | лонжерон основания |
| 625 | -75 | LC3 от пилота 500 Н (упор в руль при торможении) | -0.44 | -0.00 | +0.16 | +0.000 | -0.068 | 15 | лонжерон основания |
| 625 | -75 | LC4 момент базы 25 Н·м + поперечно 300 Н | +0.00 | +0.17 | -0.00 | +0.001 | +0.000 | 8 | верхняя поперечина 40x40x3 |
| 625 | -75 | LC5 вверх 600 Н | -0.19 | -0.00 | +0.14 | +0.000 | -0.048 | 11 | лист площадки 12 мм |
| 775 | -75 | LC1 вертикально вниз 1000 Н на ободе (опора рукой при посадке) | +0.43 | +0.00 | -0.27 | -0.000 | +0.092 | 18 | лист площадки 12 мм |
| 775 | -75 | LC2 к пилоту 500 Н (тянет руль на себя) | +0.76 | +0.00 | -0.21 | -0.000 | +0.095 | 19 | лонжерон основания |
| 775 | -75 | LC3 от пилота 500 Н (упор в руль при торможении) | -0.76 | -0.00 | +0.21 | +0.000 | -0.095 | 19 | лонжерон основания |
| 775 | -75 | LC4 момент базы 25 Н·м + поперечно 300 Н | +0.00 | +0.25 | -0.00 | +0.002 | +0.000 | 10 | верхняя поперечина 40x40x3 |
| 775 | -75 | LC5 вверх 600 Н | -0.26 | -0.00 | +0.16 | +0.000 | -0.055 | 11 | лист площадки 12 мм |

## Крепёж и соединения

| Проверка | Результат |
|---|---|
| Срез М12 8.8, одна плоскость (EN 1993-1-8, по резьбе) | 32.4 кН |
| Усилие затяжки М12 при 80 Н·м, K≈0.20 (оцинк. болт, гайка ISO 7042) | ≈33 кН (~69% пробной нагрузки 48.5 кН) |
| Сдвиг трением на болт, 2 плоскости трения, μ=0.20 | ≈13 кН |
| Седло: LC1 1000 Н на плече 275 мм → момент 275 Н·м, пара болтов 75 мм на каждом седле | ≈1.83 кН на болт (запас по срезу > 18, по трению > 7) |
| Смятие гребня 8 мм под болтом М12 | 19 МПа (допускаемое для S235 ≈ 2.5·360/1.25 = 720 МПа) |
| Телескоп: момент на стойку 138 Н·м, мин. перекрытие 210 мм (при H=775) | реакция пары направляющих ≈0.65 кН — воспринимается затянутым пакетом и вкладышами |
| Телескоп: вертикальная нагрузка 1000 Н + вес узла ~150 Н на 4 болта, двойной срез | ≈0.3 кН на плоскость — запас > 60 |
| Педали: тормоз 2000 Н по нормали на расстоянии 200 мм от оси → 400 Н·м; ось + 1 болт на дуге R250 на каждой щеке | болт дуги ≈0.80 кН, оси ≈1.8 кН (одна плоскость; запас > 18) |
| Ребро педальной площадки 40x40x3, пролёт 434, 1000 Н в середине (без учёта листа 8 мм) | σ ≈ 21 МПа, прогиб ≈ 0.08 мм |
| Башмак педалей: 3 болта М12 на сторону (сквозные, гайка ISO 7042), сдвиг 2 кН/2 стороны | ≈0.33 кН на болт — трение и опора болта с запасом > 30 |
| Кронштейн шифтера: ручник 500 Н на высоте 630 мм, плечо до верха стакана → 132 Н·м; перекрытие 135 мм | реакция направляющих ≈0.98 кН; болты М12 — срез ≈0.25 кН |
| Кручение передней поперечины сиденья от ручника: 231 Н·м на половине пролёта 270 мм | угол ≈0.14° → смещение рукояти ≈1.1 мм (+ податливость башмаков) [!] проверить замером |
| Фланец кронштейна (4 болта М12, разнос по высоте 42 мм) — боковая сила 500 Н на рукояти | момент ≈231 Н·м → растяжение ≈2.8 кН на болт (несущая способность М12 8.8 ≈ 48 кН) |
| Фронтальный кронштейн: 1000 Н на ободе, плечо 285 мм от первого ряда болтов → 285 Н·м; 2 ряда болтов с разносом 100 мм, по 2 болта | ≈1.43 кН отрыва на болт (М12 8.8 ≈ 48 кН); [!] прогиб листа 12 мм у болтов — замер |

## Масса и устойчивость

* Масса стальной части (без руля, педалей, сиденья), по модели: **≈118 кг**, центр масс X≈696 мм.
* Опрокидывание ПУСТОЙ рамы вбок от горизонтальной силы на ободе (H=775, высота обода ≈845 мм): ≈370 Н. С пилотом 80 кг на сиденье — ≈621 Н. Вывод: в работе устойчиво, но пустую раму не следует тянуть за руль вбок.
* Продольно: точка приложения нагрузок на руль (X≈700–825) и педали лежат внутри опорного контура (опоры X=20…1380); усилия педалей замыкаются через пилота на сиденье (внутренние силы).
