vlad-anisov/misha/(commit log)

2026-10-11 Concept CAD model of adjustable welded sim-rig frame
    Parametric CadQuery model (188 separate solids), STEP AP214/AP242 and STL
    exports for nominal and extreme wheel positions, interference checks,
    frame FEM estimate, ergonomic P5-P95 check, drawing sheets and docs.
    Claude-Session: https://claude.ai/code/session_01NAM6DqUmCvocfQ3tnzMJYW
    [simrig_nominal_AP214.step, simrig_nominal_AP242.step, simrig_nominal_frame.stl, simrig_nominal_with_refs.stl, simrig_wheel_high_back.stl, simrig_wheel_high_back_AP214.step, simrig_wheel_high_fwd.stl, simrig_wheel_high_fwd_AP214.step]
2026-10-11 Regenerate drawing sheets, PDF and limit exports to wheel extremes
    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
2026-10-11 Simplify design: single saddle hole pair, one pedal arc, steel-only liners, unified 50x8 fins and 8 mm plates
    - Fore-aft: step 25 (7 positions), deck back to 420x260, 8 mm plate without ribs
    - Pedal angle: pivot + one R250 arc (4 bolts)
    - Telescope: calibrated steel liners only (no PA liners / M10 jack screw)
    - Weld nuts only on wheel unit; pedals and seat use through bolts with ISO 7042
    - Bolts M12x40 and M12x80 only; 166 parts, no interference in 11 configs
    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
    [simrig_nominal_AP214.step, simrig_nominal_AP242.step, simrig_nominal_frame.stl, simrig_nominal_with_refs.stl, simrig_wheel_high_back.stl, simrig_wheel_high_back_AP214.step, simrig_wheel_high_fwd.stl, simrig_wheel_high_fwd_AP214.step]
2026-10-11 Fabrication-ready simplification: laser parts, solid posts, shifter and front mount brackets
    - All holed plates/fins laser-cut from 8 mm sheet (liners 2 mm); post holes by tube laser
    - Inner posts solid 40x40 square (no sleeves, no crushing); no weld nuts in adjustments
    - Shifter/handbrake side mount on front seat crossbar (left or right), crossbars 50x50x3
    - Optional wheel-base front mount bracket; inner tower gussets; pedal tray 8 mm + 40x40 ribs
    - Unified stock: tube 40x40x3, 50x50x3, square 40, sheet 8 mm
    - Fabrication pack: DXF, cut list, assembly/welding sequence; nut-on-bolt check in build
    Claude-Session: https://claude.ai/code/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
    [cut_list.csv, laser_parts.csv, simrig_nominal_AP214.step, simrig_nominal_AP242.step, simrig_nominal_frame.stl, simrig_nominal_with_refs.stl, simrig_wheel_high_back.stl, simrig_wheel_high_back_AP214.step]
2026-10-11 Fix review findings: removable pedal bolts, 4-face liners, working feet, 3-bolt seat shoes
    - Pedal shoe bolts head-outside, pivot/arc bolts from inside tray (were trapped)
    - Telescope and shifter cup liners on all 4 faces (X play removed)
    - Foot plates extended outboard so leveling studs have travel
    - Seat shoes 150 mm with 3 bolts; seat crossbar range 900-1225
    - Side flange holes moved for 18 mm socket; shifter gusset off the shoe bolt path
    - New checks: bolt extraction path and socket access; drill jig L29, DXF engraving
    - Docs: weld map, tolerances, 80 Nm torque, corrected inconsistencies
    Claude-Session: https://claude.ai/code/sessi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
    [cut_list.csv, laser_parts.csv, simrig_nominal_AP214.step, simrig_nominal_AP242.step, simrig_nominal_frame.stl, simrig_nominal_with_refs.stl, simrig_wheel_high_back.stl, simrig_wheel_high_back_AP214.step]
2026-10-11 Revision 4: fixes from independent critic review
    - Fit tolerance: shoe/saddle cheeks with 1 mm gap, fins tacked with crossbars as jig
    - Telescope: calibrated 40x40 square, P-unit welded first, liners step 0.25, M10 press screw
    - Wheel deck 12 mm; FEM corrected (base fixed to plate); front mount with 2 bolt rows
    - Ergonomics: base 1400 (+100 front), wheel height 625-775 nominal 700,
    pedal travel 260-485 and two pivot heights, seat 1000-1325
    - One-person height adjustment via M16 jack nut; identical seat crossbars with end flanges
    - DXF engraving of part number and FRONT/UP arrows; docs rewritten for revision 4
    Claude-Session: https://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
    [cut_list.csv, laser_parts.csv, simrig_nominal_AP214.step, simrig_nominal_AP242.step, simrig_nominal_frame.stl, simrig_nominal_with_refs.stl, simrig_wheel_high_back.stl, simrig_wheel_high_back_AP214.step]
2026-10-11 Add questionnaire for the workshop (laser, tube laser, bending, welding)
    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
2026-10-11 Open-items status, ordinary-steel liners, report generator, BOM label fixes
    - docs/07_status_open_items.md: what must be decided before ordering cutting
    - liners from ordinary cold-rolled steel 1.5/2.0/2.5 instead of stainless
    - fix stale BOM labels (rail L=1400, deck plate 12 mm)
    - short workshop questionnaire; cad/report.py for the two PDF documents
    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
    [laser_parts.csv, Л01_fin_pedal_t8.dxf, Л02_fin_seat_t8.dxf, Л03_foot_plate_t8.dxf, Л04_tower_gusset_outer_t8.dxf, Л05_tower_liner_steel_t2.dxf, Л06_tower_liner_x_t2.dxf, Л07_tower_gusset_inner_t8.dxf]
2026-10-11 Add overview and full documentation PDFs; redraw sheets with revision stamp
    - 1_Кратко_о_раме.pdf: plain-language overview (looks, adjustments, materials and quantities, work, open items)
    - 2_Документация_для_изготовления.pdf: document register, status, all docs, tables, BOM, calc, sheets S01-S12
    - drawing title block: revision 4 stamp, long titles no longer clipped
    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
